clarkmt2/ECE_445_WaterBlaster/README.md

# ECE_445_WaterBlaster
Design, Firmware, and Documentation for Fully Electric Water Blaster
