clarkmt2/ECE_445_WaterBlaster/notebook/clarkmt2/SketchOfPreliminaryDesign.jpg

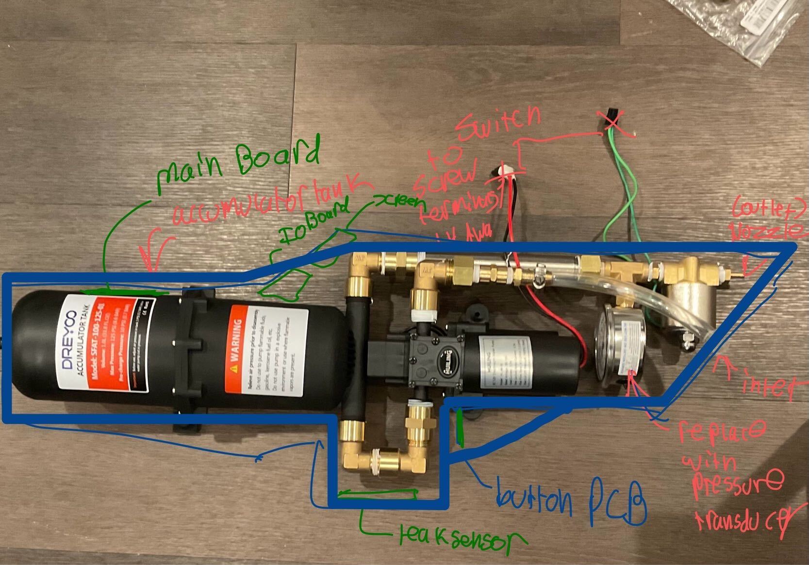
notebook/clarkmt2/SketchOfPreliminaryDesign.jpg
