clarkmt2/ECE_445_WaterBlaster/notebook/jaejin2/mechanicaldesign.png

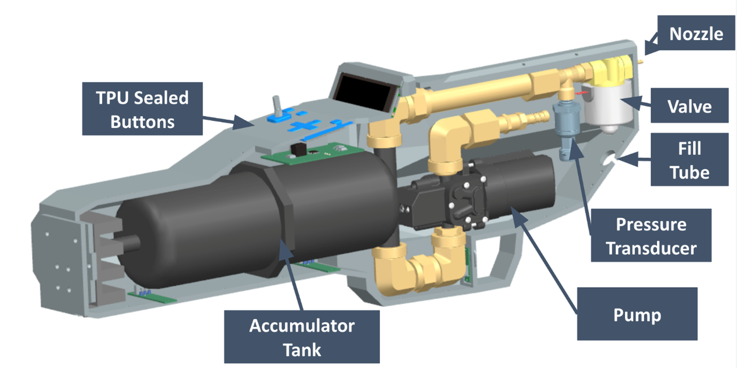
notebook/jaejin2/mechanicaldesign.png
