clarkmt2/ECE_445_WaterBlaster/cad_files/IOBoardV1.step

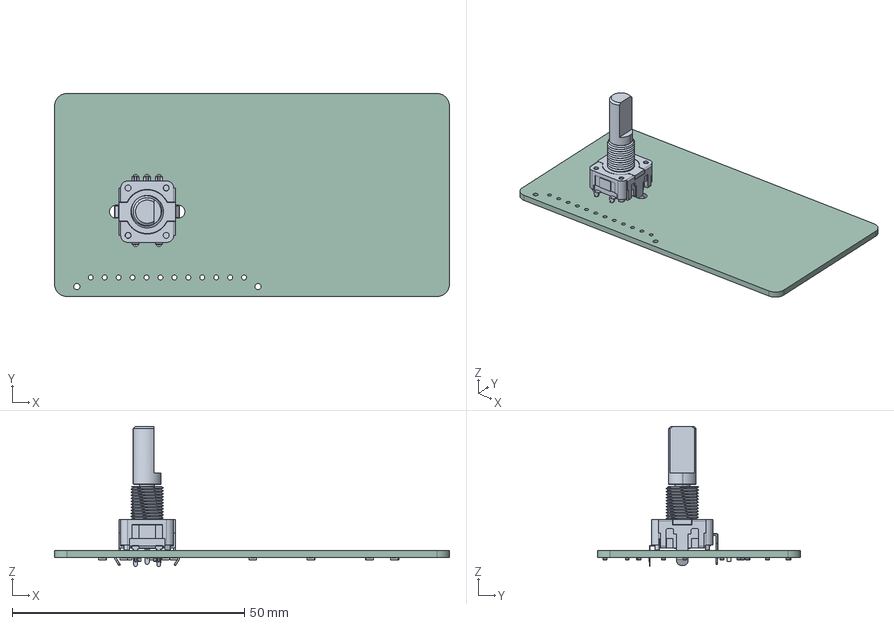
[picture p19: CAD file, 2025-04-20]
cad_files/IOBoardV1.step
85.0 x 43.7 x 30.2 mm
pec11r-4020f-s0024
C_0603_1608Metric x 2
R_0603_1608Metric x 20
IOBoardV1_PCB
