clarkmt2/ECE_445_WaterBlaster/cad_files/WaterBlasterV1.0/2WG025.STEP

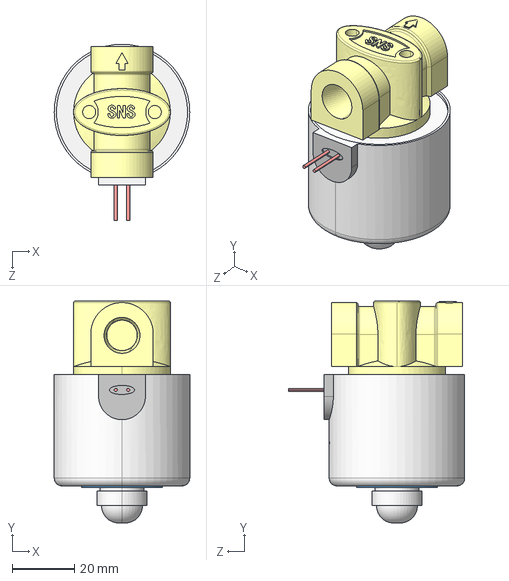
[picture p20: CAD file, 2025-04-20]
cad_files/WaterBlasterV1.0/2WG025.STEP
43.4 x 71.1 x 56.5 mm
