clarkmt2/ECE_445_WaterBlaster/pcb/IOBoardV1/IOBoardV1/TriggerButton V1/TriggerButton V1.step

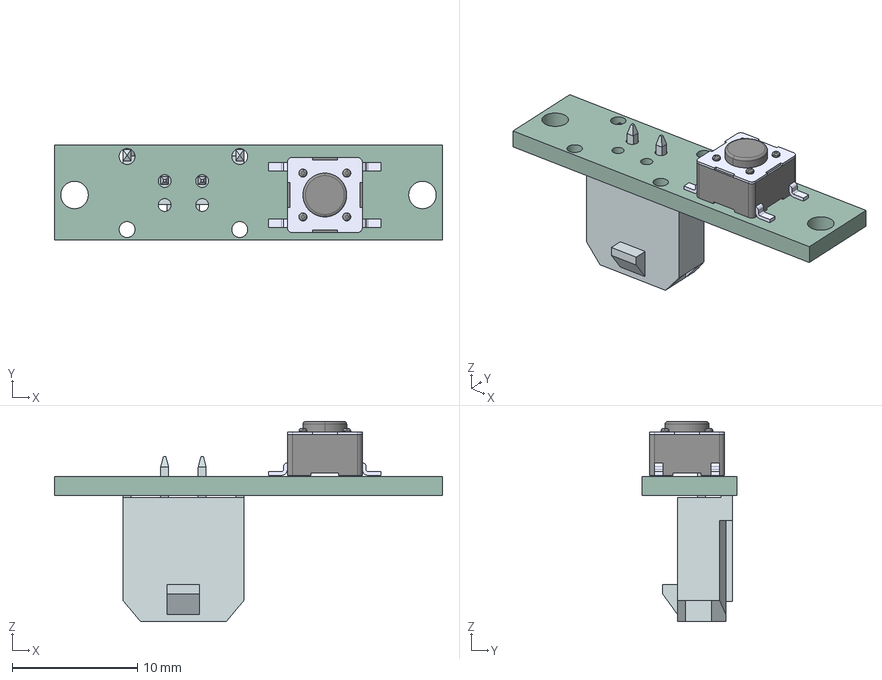
[picture p21: CAD file, 2025-05-02]
pcb/IOBoardV1/IOBoardV1/TriggerButton V1/TriggerButton V1.step
31.0 x 7.60 x 16.0 mm
PTS645SL43SMTR92 LFS
TriggerButton V1_PCB
