clarkmt2/ECE_445_WaterBlaster/pcb/LeakDetectionSensor/LeakDetectionSensorV1.step

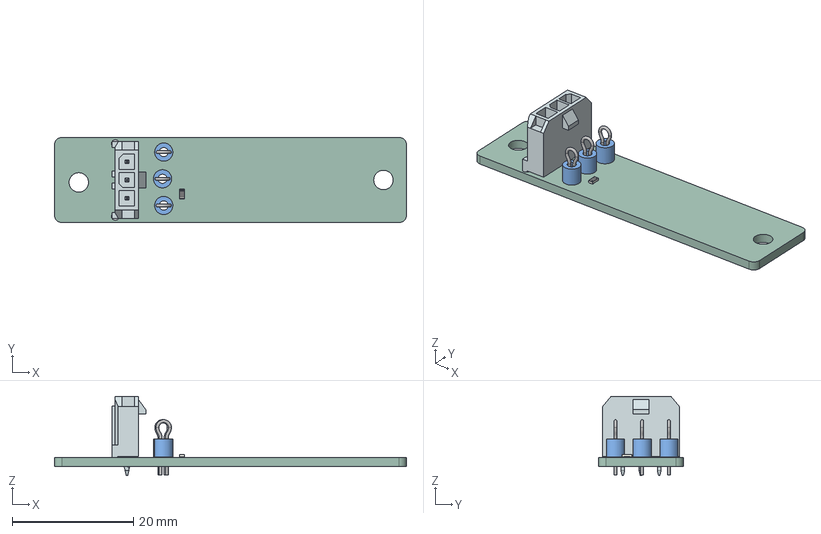
[picture p22: CAD file, 2025-04-20]
pcb/LeakDetectionSensor/LeakDetectionSensorV1.step
58.0 x 14.0 x 13.1 mm
TestPoint_Loop_D2.54mm_Drill1.5mm_Beaded x 3
R_0603_1608Metric
LeakDetectionSensorV1_PCB
