clarkmt2/ECE_445_WaterBlaster/pcb/WaterBlaster/WaterBlasterV2/WaterBlasterV2/WaterBlasterV2.step

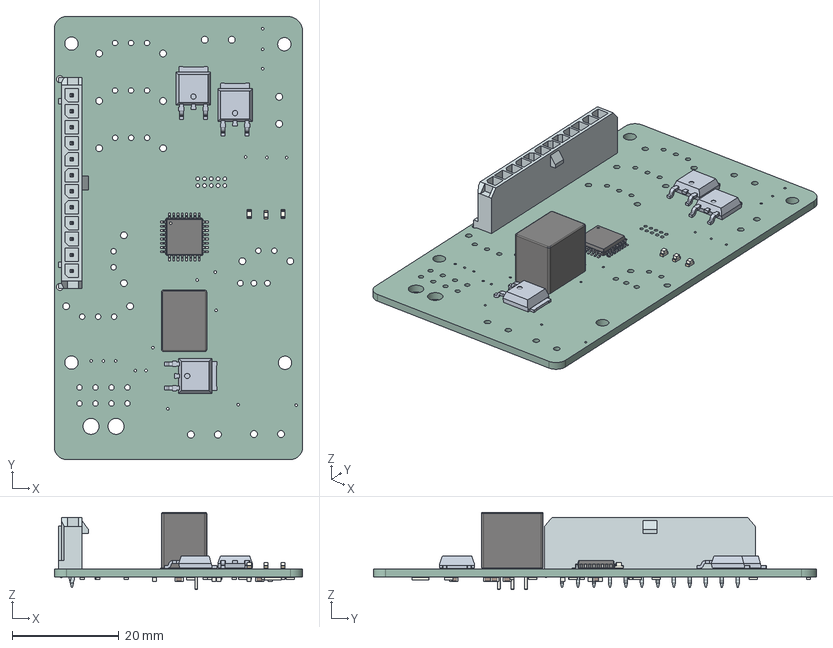
[picture p23: CAD file, 2025-04-20]
pcb/WaterBlaster/WaterBlasterV2/WaterBlasterV2/WaterBlasterV2.step
46.6 x 83.2 x 14.5 mm
LQFP-32_7x7mm_P0.8mm
WaterBlasterV2 1.2.1 x 3
LED_0603_1608Metric x 3
Converter_DCDC_RECOM_R-78E-0.5_THT
Fuse_1206_3216Metric x 2
R_0603_1608Metric x 12
C_0603_1608Metric x 8
Fuse_0603_1608Metric x 3
WaterBlasterV2_PCB
