clarkmt2/ECE_445_WaterBlaster/cad_files/WaterBlasterV1.0/0,250' NPT TEE.STEP

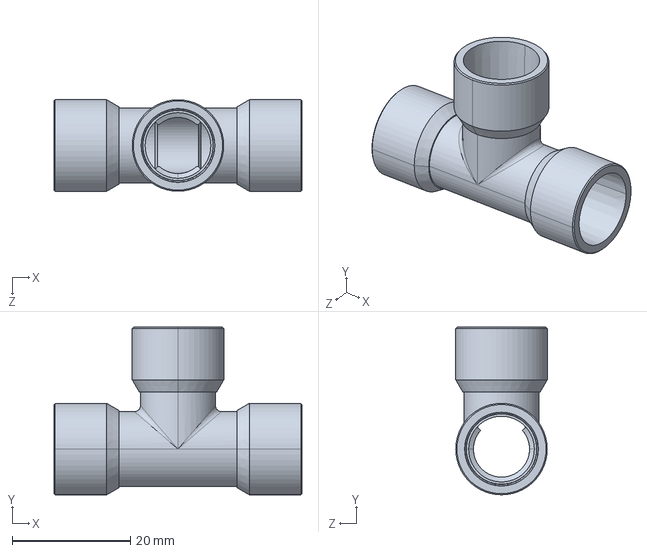
[picture p24: CAD file, 2025-04-20]
cad_files/WaterBlasterV1.0/0,250' NPT TEE.STEP
42.0 x 28.4 x 15.5 mm
