clarkmt2/ECE_445_WaterBlaster/cad_files/WaterBlasterV1.0/NHD-0420CW-AB3.step

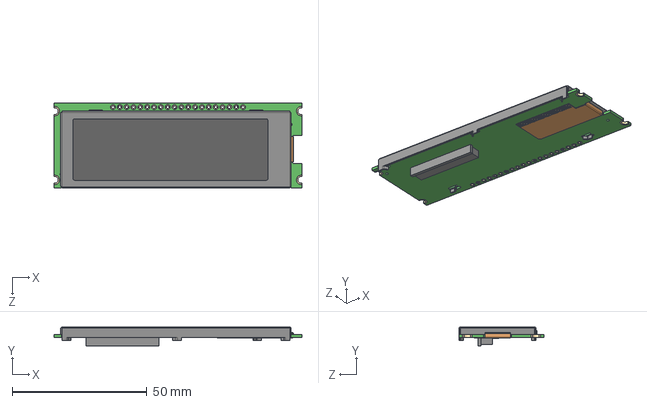
[picture p25: CAD file, 2025-03-13]
cad_files/WaterBlasterV1.0/NHD-0420CW-AB3.step
92.0 x 7.00 x 31.5 mm
