clarkmt2/ECE_445_WaterBlaster/(list of files, cad)

Other CAD files:
pcb/TriggerButton V1/TriggerButton V1.step
cad_files/0.25inNPTFemaleFemaleConnector.prt
cad_files/0.25inNPTFemaleFemaleConnectorv2.prt
cad_files/0.25inNPTMaleMaleConnector.prt
cad_files/0.25to0.125inNPTMaletoBarb.prt
cad_files/0.25to0.375inNPTMaletoBarb.prt
cad_files/0.25to0.5inNPTFemaletoMale.prt
cad_files/0.25to0.5inNPTMaletoFemaleAdapter.prt
cad_files/0.5inNPT90Degree.prt
cad_files/0.5inNPTFemaleFemaleCoupling.prt
cad_files/0.5inNPTMaleMaleConnector.prt
cad_files/436500227.prt
cad_files/436500315.prt
cad_files/436501215.prt
cad_files/C_0603_1608Metric.prt
cad_files/C_0603_1608Metric34313.prt
cad_files/Converter_DCDC_RECOM_R-78E-0.5_THT.prt
cad_files/Fuse_0603_1608Metric.prt
cad_files/Fuse_1206_3216Metric.prt
cad_files/IOBoardV1 _2__step.prt
cad_files/IOBoardV1_PCB.prt
cad_files/IOBoardV1_step.prt
cad_files/LED_0603_1608Metric.prt
cad_files/LQFP-32_7x7mm_P0.8mm.prt
cad_files/LeakDetectionSensorV1 _1__step.prt
cad_files/LeakDetectionSensorV1_PCB.prt
cad_files/NHD-0420CW-AB3.prt
cad_files/PTS645SL43SMTR92 LFS.prt
cad_files/PrusaBuildSizemk1.0.prt
cad_files/R_0603_1608Metric.prt
cad_files/R_0603_1608Metric33484.prt
cad_files/R_0603_1608Metric4886.prt
cad_files/TO-252-2.prt
cad_files/TestPoint_Loop_D2.54mm_Drill1.5mm_Beaded.prt
cad_files/TriggerButton V1 _1__step.prt
cad_files/TriggerButton V1_PCB.prt
cad_files/TriggerButton.prt
cad_files/WaterBlasterV1.0/0,250' NPT TEE.prt
cad_files/WaterBlasterV1.0/2WG025.prt
cad_files/WaterBlasterV1.0/BladderEnclosureV1.prt
cad_files/WaterBlasterV1.0/BladderEnclosureV2.prt
cad_files/WaterBlasterV1.0/NHD-0420CW-AB3.prt
cad_files/WaterBlasterV1.0/PrusaBuildSizemk1.0.prt
cad_files/WaterBlasterV1.0/Pump/90012-029-67.prt
cad_files/WaterBlasterV1.0/Pump/DIN7985-M4X16.prt
cad_files/WaterBlasterV1.0/Pump/DIN7991-M4X10.prt
cad_files/WaterBlasterV1.0/Pump/MDP-100-000_ASM.prt
cad_files/WaterBlasterV1.0/Pump/MDP-100-001.prt
cad_files/WaterBlasterV1.0/Pump/MDP-100-002.prt
cad_files/WaterBlasterV1.0/Pump/MDP-100-003.prt
cad_files/WaterBlasterV1.0/Pump/MDP-100-004.prt
cad_files/WaterBlasterV1.0/Pump/MDP-100-005.prt
cad_files/WaterBlasterV1.0/Pump/MDP-100-006.prt
cad_files/WaterBlasterV1.0/Pump/MDP-100-007.prt
cad_files/WaterBlasterV1.0/Pump/MDP-100-008.prt
cad_files/WaterBlasterV1.0/Pump/MDP-100-009.prt
cad_files/WaterBlasterV1.0/Pump/MDP-100-010.prt
cad_files/WaterBlasterV1.0/Pump/MDP-100-011.prt
cad_files/WaterBlasterV1.0/Pump/MDP-100-012.prt
cad_files/WaterBlasterV1.0/Pump/MDP-100-013.prt
cad_files/WaterBlasterV1.0/Pump/MDP-100-014.prt
cad_files/WaterBlasterV1.0/Pump/MDP-100-015.prt
cad_files/WaterBlasterV1.0/Pump/MDP-100-016.prt
cad_files/WaterBlasterV1.0/Pump/MDP-100-017.prt
cad_files/WaterBlasterV1.0/Pump/MDP-100-018.prt
cad_files/WaterBlasterV1.0/Pump/MDP-100-019.prt
cad_files/WaterBlasterV1.0/Pump/MDP-100-020.prt
cad_files/WaterBlasterV1.0/Pump/MDP-100-021.prt
cad_files/WaterBlasterV1.0/Pump/MDP-200-000_ASM.prt
cad_files/WaterBlasterV1.0/Pump/MDP-200-001.prt
cad_files/WaterBlasterV1.0/Pump/MDP-200-100_ASM.prt
cad_files/WaterBlasterV1.0/Pump/MDP-200-101.prt
cad_files/WaterBlasterV1.0/Pump/MDP-200-102.prt
cad_files/WaterBlasterV1.0/Pump/MDP-200-103.prt
cad_files/WaterBlasterV1.0/Pump/MDP-200-104.prt
cad_files/WaterBlasterV1.0/Pump/MDP-200-105.prt
cad_files/WaterBlasterV1.0/Pump/MDP-200-106.prt
cad_files/WaterBlasterV1.0/Pump/MDP-200-107.prt
cad_files/WaterBlasterV1.0/Pump/MDP-200-108.prt
cad_files/WaterBlasterV1.0/Pump/MDP-200-109.prt
cad_files/WaterBlasterV1.0/Pump/MDP-200-110.prt
cad_files/WaterBlasterV1.0/Pump/MDP-200-111.prt
cad_files/WaterBlasterV1.0/Pump/MDP-200-112.prt
cad_files/WaterBlasterV1.0/Pump/MDP-200-113.prt
cad_files/WaterBlasterV1.0/Pump/MDP-300-000.prt
cad_files/WaterBlasterV1.0/Pump/MDP-300-000_ASM.prt
cad_files/WaterBlasterV1.0/Pump/MDP-300-001.prt
cad_files/WaterBlasterV1.0/Pump/SKF_619_5-2Z_1_ASM.prt
cad_files/WaterBlasterV1.0/Pump/SKF_619_5-2Z_ASM.prt
cad_files/WaterBlasterV1.0/Pump/SKF_W_636-2RS1_1_ASM.prt
cad_files/WaterBlasterV1.0/Pump/SKF_W_636-2RS1_ASM.prt
cad_files/WaterBlasterV1.0/Pump/_SKF_619_5-2Z_PART1.prt
cad_files/WaterBlasterV1.0/Pump/_SKF_619_5-2Z_PART2.prt
cad_files/WaterBlasterV1.0/Pump/_SKF_619_5-2Z_PART3.prt
cad_files/WaterBlasterV1.0/Pump/_SKF_619_5-2Z_PART4.prt
cad_files/WaterBlasterV1.0/Pump/_SKF_W_636-2RS1_PART1.prt
cad_files/WaterBlasterV1.0/Pump/_SKF_W_636-2RS1_PART2.prt
cad_files/WaterBlasterV1.0/Pump/_SKF_W_636-2RS1_PART3.prt
cad_files/WaterBlasterV1.0/Pump/mdp-000-000.prt
cad_files/WaterBlasterV1.0/WaterBlasterLayoutV1.prt
cad_files/WaterBlasterV1.0/WaterBlasterV1.prt
cad_files/WaterBlasterV2 1.2.1.prt
cad_files/WaterBlasterV2 _2__step.prt
cad_files/WaterBlasterV2_PCB.prt
cad_files/accumulator.prt
cad_files/battery_holder.prt
cad_files/board1/43650121527303.prt
cad_files/board1/C_0603_1608Metric25576.prt
cad_files/board1/IOBoardV1_PCB167385.prt
cad_files/board1/IOBoardV1_copper.prt
cad_files/board1/IOBoardV1_silkscreen.prt
cad_files/board1/IOBoardV1_soldermask.prt
cad_files/board1/PTS645SL43SMTR92 LFS168.prt
cad_files/board1/R_0603_1608Metric26449.prt
cad_files/board1/pec11r-4020f-s00243929.prt
cad_files/button_covers.prt
cad_files/button_covers2.prt
cad_files/dcdc.prt
cad_files/pec11r-4020f-s0024.prt
cad_files/pressure_transducer.prt
cad_files/waterblaster_body_full.prt
cad_files/waterblaster_layout.prt
cad_files/waterblaster_leftback.prt
cad_files/waterblaster_leftfront.prt
cad_files/waterblaster_leftmiddle.prt
cad_files/waterblaster_leftnozzle.prt
cad_files/waterblaster_rightback.prt
cad_files/waterblaster_rightfront.prt
cad_files/waterblaster_rightmiddle.prt
cad_files/waterblaster_rightnozzle.prt
cad_files/waterblaster_section1.prt
cad_files/waterblaster_section2.prt
cad_files/waterblaster_wavelinkassembly.prt
