clarkmt2/ECE_445_WaterBlaster/pcb/WaterBlaster/WaterBlasterLite/WaterBlasterLite/WaterBlasterLite.kicad_pcb

## KiCad design pcb/WaterBlaster/WaterBlasterLite/WaterBlasterLite/WaterBlasterLite.kicad_pcb (2025-05-02)

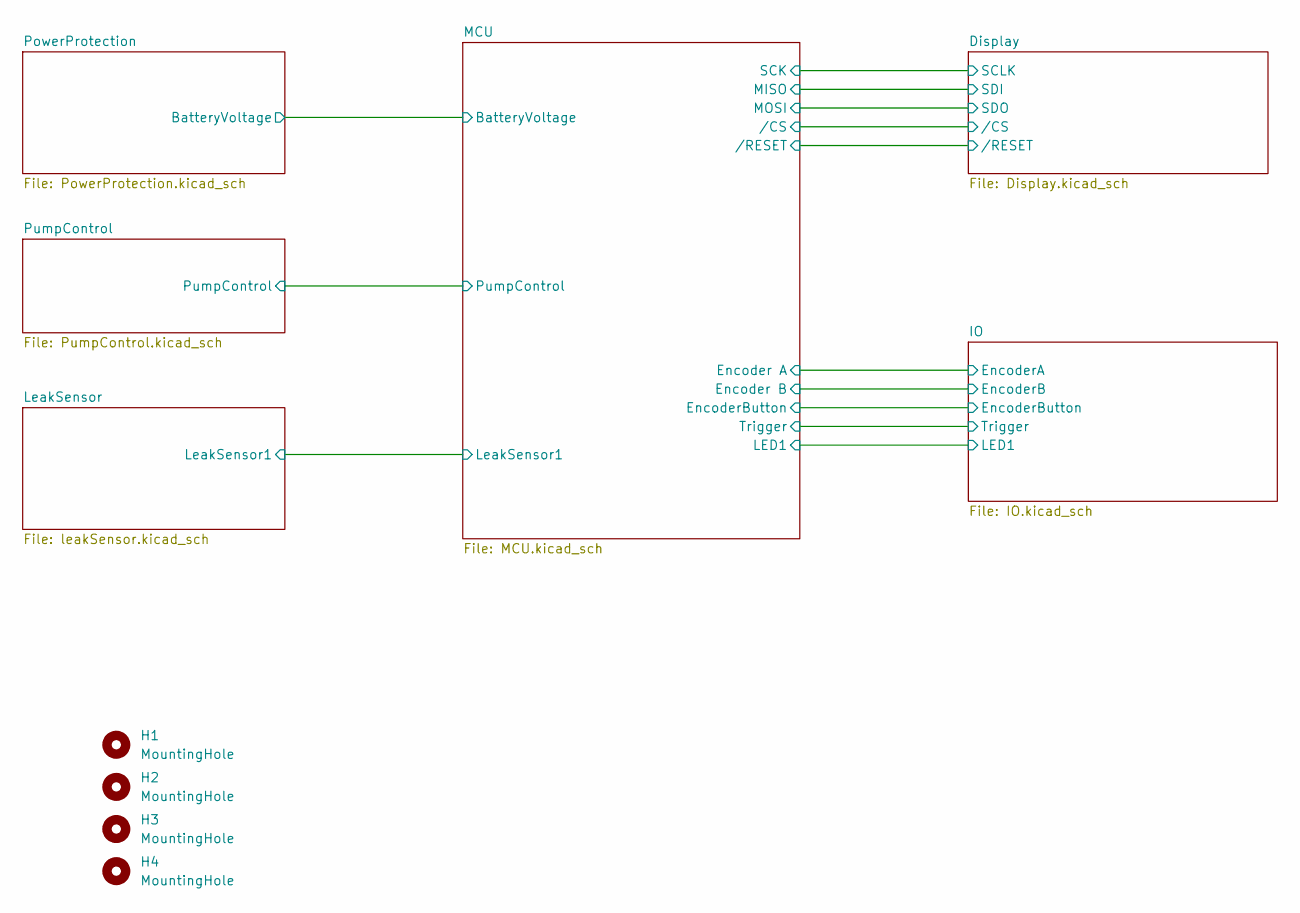
[picture p26: schematic WaterBlasterLite.kicad_sch]

Parts:
H1, H2, H3, H4: MountingHole; MountingHole_2.5mm

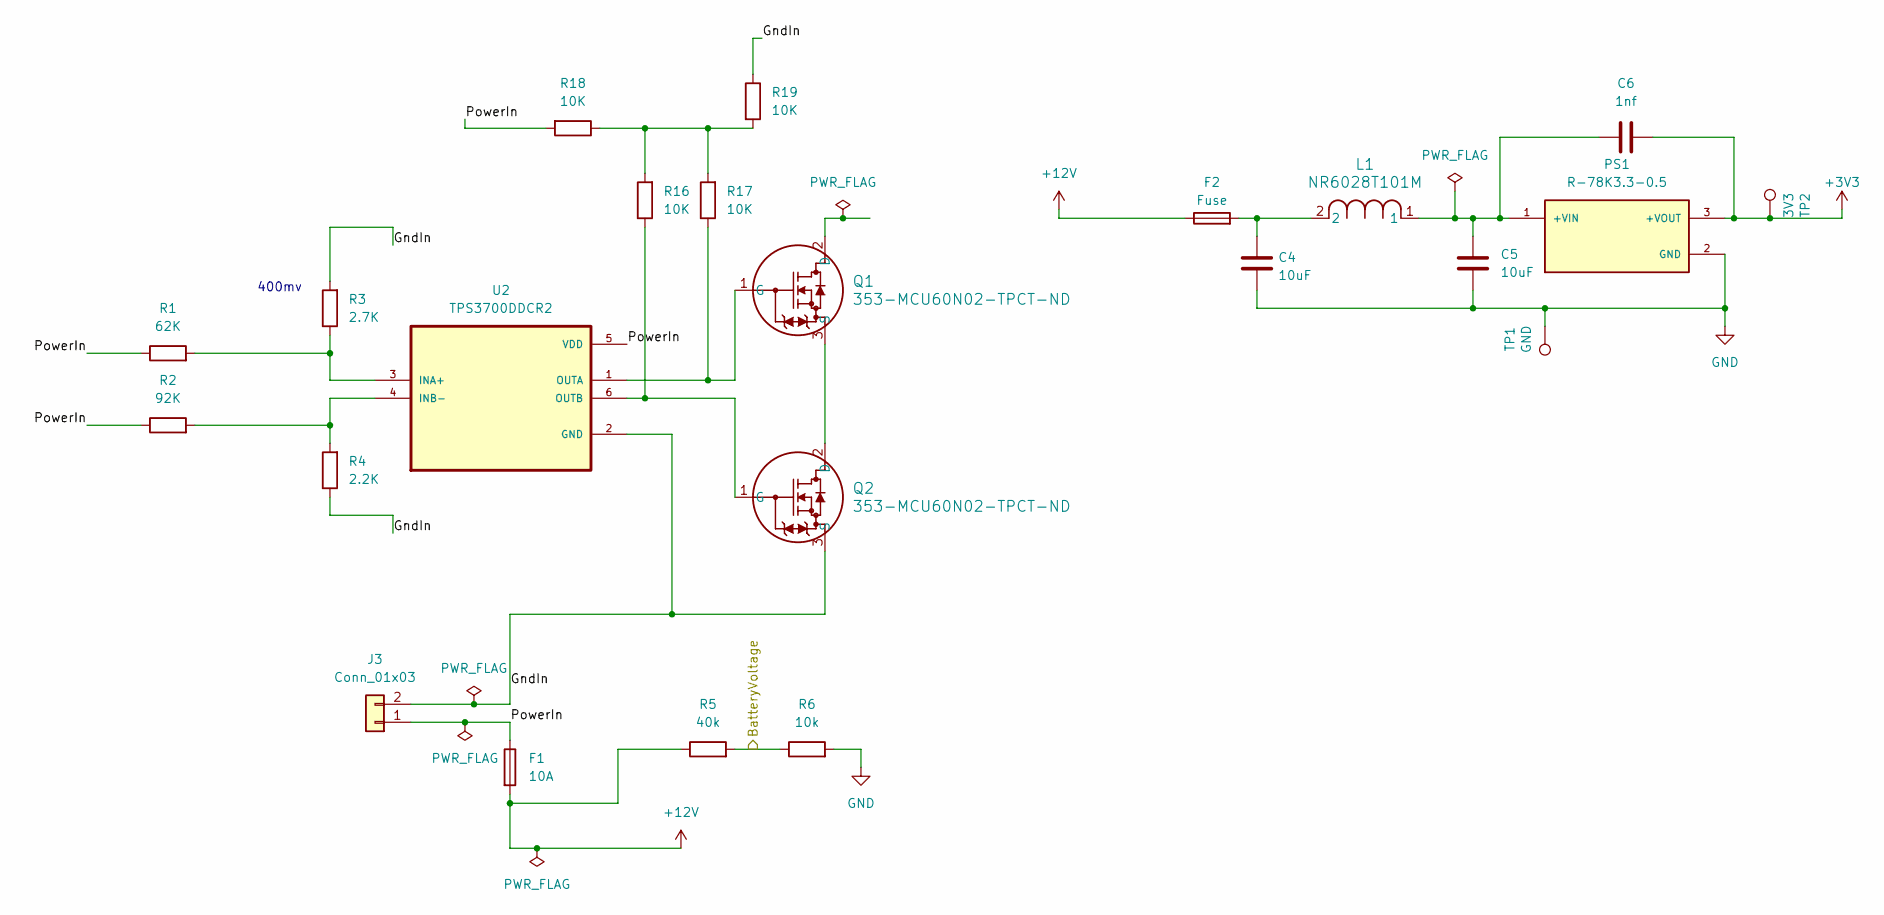
[picture p27: schematic PowerProtection.kicad_sch]

Parts:
C4: 10uF; C_0603_1608Metric_Pad1.08x0.95mm_HandSolder; MPN CAP CER 10UF 100V X5R 0603
C5: 10uF; C_0603_1608Metric_Pad1.08x0.95mm_HandSolder; MPN CAP CER 4.7UF 50V X5R 0603
C6: 1nf; C_0603_1608Metric_Pad1.08x0.95mm_HandSolder; MPN CAP CER 4.7UF 50V X5R 0603
F1: 10A; Fuse_1206_3216Metric
F2: Fuse; Fuse_0603_1608Metric
J3: Conn_01x03; PHOENIX_1985865
L1: NR6028T101M; IND_TAIYO_NR6028_TAY
PS1: R-78K3.3-0.5; CONV_R-78K3.3-0.5; PARTREV 0/2023
Q1, Q2: 353-MCU60N02-TPCT-ND; TO-252-2
R1: 62K; C_0603_1608Metric_Pad1.08x0.95mm_HandSolder
R2: 92K; C_0603_1608Metric_Pad1.08x0.95mm_HandSolder
R3: 2.7K; C_0603_1608Metric_Pad1.08x0.95mm_HandSolder
R4: 2.2K; C_0603_1608Metric_Pad1.08x0.95mm_HandSolder
R5: 40k; C_0603_1608Metric_Pad1.08x0.95mm_HandSolder
R6: 10k; C_0603_1608Metric_Pad1.08x0.95mm_HandSolder
R16, R17, R18, R19: 10K; C_0603_1608Metric_Pad1.08x0.95mm_HandSolder
TP1: GND; TestPoint_THTPad_D1.0mm_Drill0.5mm
TP2: 3V3; TestPoint_THTPad_D1.0mm_Drill0.5mm
U2: TPS3700DDCR2; SOT95P280X110-6N

Connections:
+3V3: C6.2, PS1.3 (+VOUT), TP2.1; also elsewhere on the board
+12V: F1.2, F2.1, R5.1; also elsewhere on the board
/MCU/BatteryVoltage: R5.2, R6.1; also elsewhere on the board
/PowerProtection/GndIn: J3.2, Q2.3 (S), R3.2, R4.1, R19.1, U2.2 (GND)
/PowerProtection/PowerIn: F1.1, J3.1, R1.1, R2.1, R18.2, U2.5 (VDD)
GND: C4.2, C5.2, PS1.2 (GND), R6.2, TP1.1; also elsewhere on the board
unnamed: C4.1, F2.2, L1.2
unnamed: C5.1, C6.1, L1.1, PS1.1 (+VIN)
unnamed: Q1.1 (G), R17.1, U2.1 (OUTA)
unnamed: Q1.3 (S), Q2.2 (D)
unnamed: Q2.1 (G), R16.1, U2.6 (OUTB)
unnamed: R16.2, R17.2, R18.1, R19.2
unnamed: R1.2, R3.1, U2.3 (INA+)
unnamed: R2.2, R4.2, U2.4 (INB-)

Notes on the sheet:
400mv

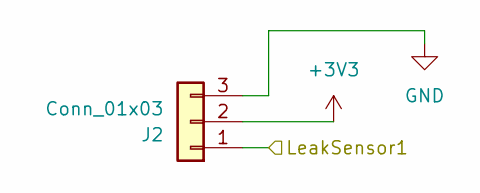
[picture p28: schematic leakSensor.kicad_sch]

Parts:
J2: Conn_01x03; MOLEX_436500317

Connections:
+3V3: J2.2; also elsewhere on the board
/LeakSensor/LeakSensor1: J2.1; also elsewhere on the board
GND: J2.3; also elsewhere on the board

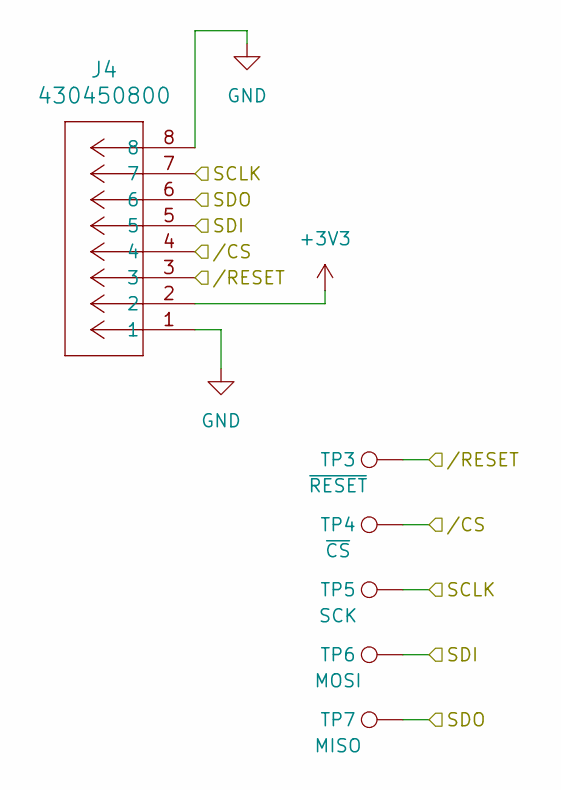
[picture p29: schematic Display.kicad_sch]

Parts:
J4: 430450800; CON_430450800_MOL
TP3: ~{RESET}; TestPoint_THTPad_D1.0mm_Drill0.5mm
TP4: ~{CS}; TestPoint_THTPad_D1.0mm_Drill0.5mm
TP5: SCK; TestPoint_THTPad_D1.0mm_Drill0.5mm
TP6: MOSI; TestPoint_THTPad_D1.0mm_Drill0.5mm
TP7: MISO; TestPoint_THTPad_D1.0mm_Drill0.5mm

Connections:
+3V3: J4.2; also elsewhere on the board
/Display/SCLK: J4.7, TP5.1; also elsewhere on the board
/Display/SDI: J4.5, TP6.1; also elsewhere on the board
/Display/SDO: J4.6, TP7.1; also elsewhere on the board
/Display//CS: J4.4, TP4.1; also elsewhere on the board
/Display//RESET: J4.3, TP3.1; also elsewhere on the board
GND: J4.1, J4.8; also elsewhere on the board

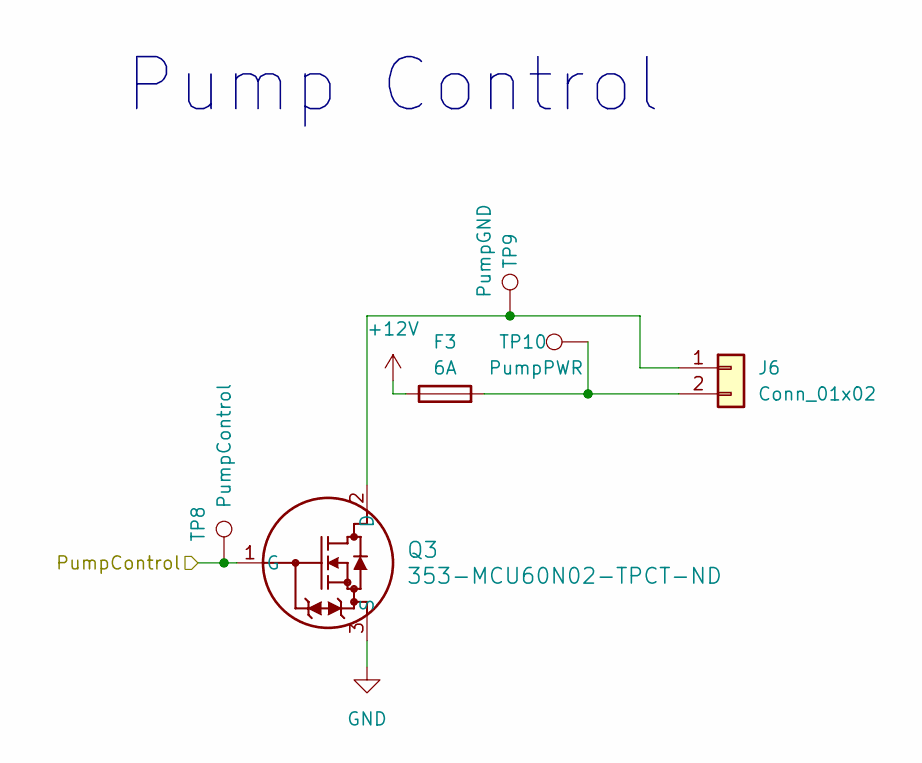
[picture p30: schematic PumpControl.kicad_sch]

Parts:
F3: 6A; Fuse_1206_3216Metric_Pad1.42x1.75mm_HandSolder
J6: Conn_01x02; PHOENIX_1985865
Q3: 353-MCU60N02-TPCT-ND; TO-252-2
TP8: PumpControl; TestPoint_THTPad_D1.0mm_Drill0.5mm
TP9: PumpGND; TestPoint_THTPad_D1.0mm_Drill0.5mm
TP10: PumpPWR; TestPoint_THTPad_D1.0mm_Drill0.5mm

Connections:
+12V: F3.1; also elsewhere on the board
/MCU/PumpControl: Q3.1 (G), TP8.1; also elsewhere on the board
GND: Q3.3 (S); also elsewhere on the board
unnamed: J6.1, Q3.2 (D), TP9.1
unnamed: F3.2, J6.2, TP10.1

Notes on the sheet:
Pump Control

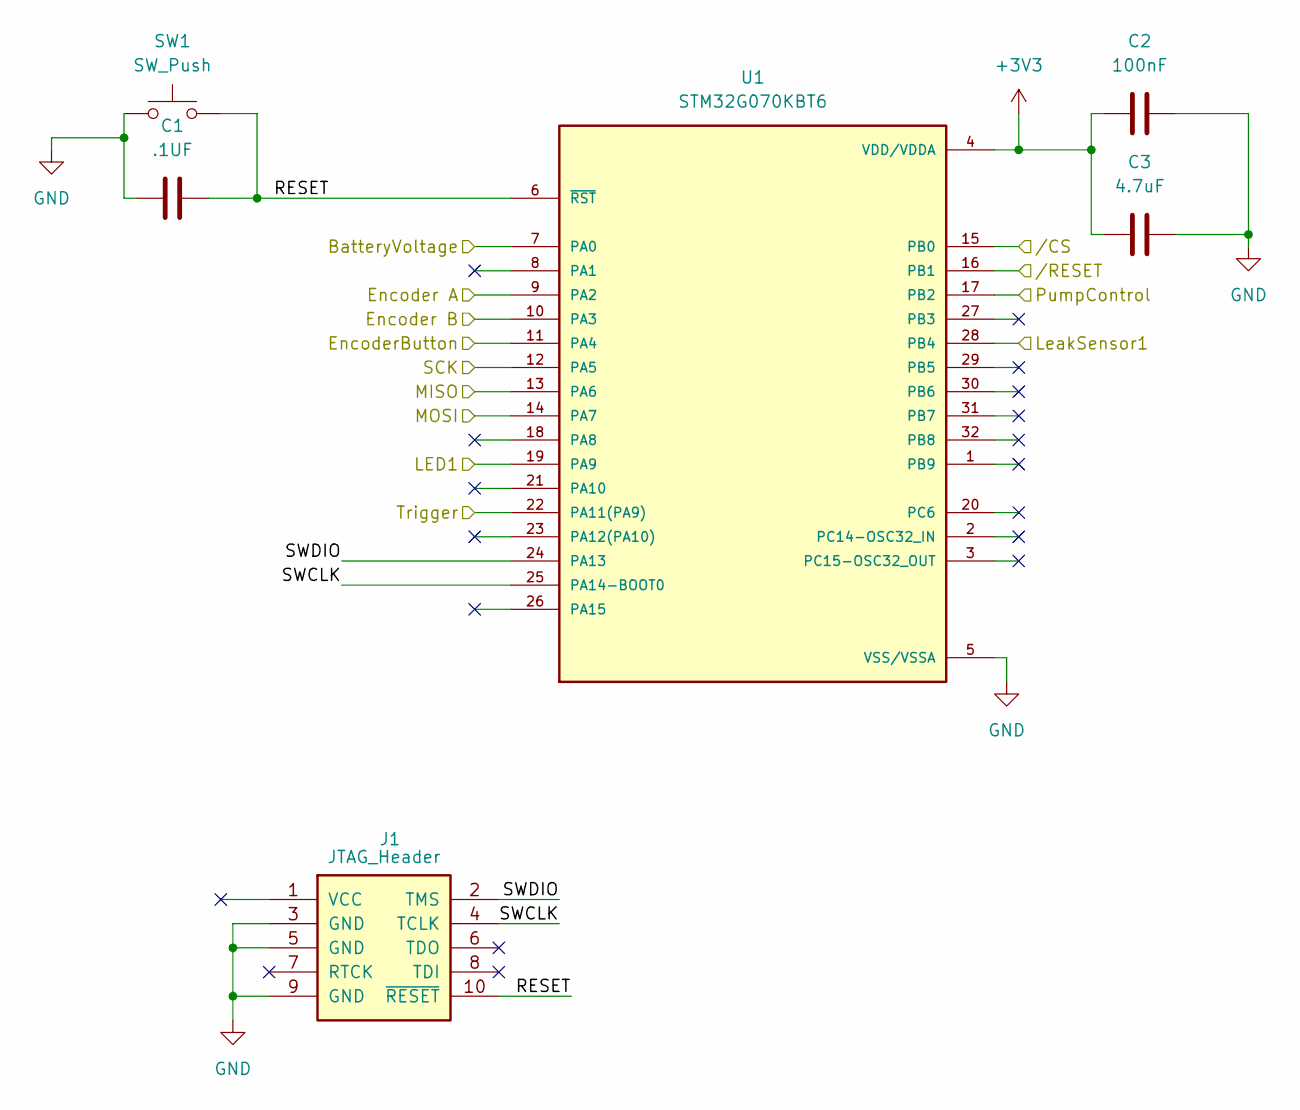
[picture p31: schematic MCU.kicad_sch]

Parts:
C1: .1UF; C_0603_1608Metric_Pad1.08x0.95mm_HandSolder
C2: 100nF; C_0603_1608Metric_Pad1.08x0.95mm_HandSolder
C3: 4.7uF; C_0603_1608Metric_Pad1.08x0.95mm_HandSolder
J1: JTAG_Header; CONN_3220-10-0100-00_CNC; MPN 3220-10-0100-00
SW1: SW_Push; PTS645SL43SMTR92LFS_CNK
U1: STM32G070KBT6; LQFP-32_7x7mm_P0.8mm; PARTREV 2

Connections:
+3V3: C2.1, C3.1, U1.4 (VDD/VDDA); also elsewhere on the board
/Display/SCLK: U1.12 (PA5); also elsewhere on the board
/Display/SDI: U1.13 (PA6); also elsewhere on the board
/Display/SDO: U1.14 (PA7); also elsewhere on the board
/Display//CS: U1.15 (PB0); also elsewhere on the board
/Display//RESET: U1.16 (PB1); also elsewhere on the board
/IO/EncoderA: U1.9 (PA2); also elsewhere on the board
/IO/EncoderB: U1.10 (PA3); also elsewhere on the board
/IO/EncoderButton: U1.11 (PA4); also elsewhere on the board
/IO/LED1: U1.19 (PA9); also elsewhere on the board
/IO/Trigger: U1.22 (PA11(PA9)); also elsewhere on the board
/LeakSensor/LeakSensor1: U1.28 (PB4); also elsewhere on the board
/MCU/BatteryVoltage: U1.7 (PA0); also elsewhere on the board
/MCU/PumpControl: U1.17 (PB2); also elsewhere on the board
/MCU/RESET: C1.1, J1.10 (~RESET), SW1.2, U1.6 (~RST)
/MCU/SWCLK: J1.4 (TCLK), U1.25 (PA14-BOOT0)
/MCU/SWDIO: J1.2 (TMS), U1.24 (PA13)
GND: C1.2, C2.2, C3.2, J1.3 (GND), J1.5 (GND), J1.9 (GND), SW1.1, U1.5 (VSS/VSSA); also elsewhere on the board

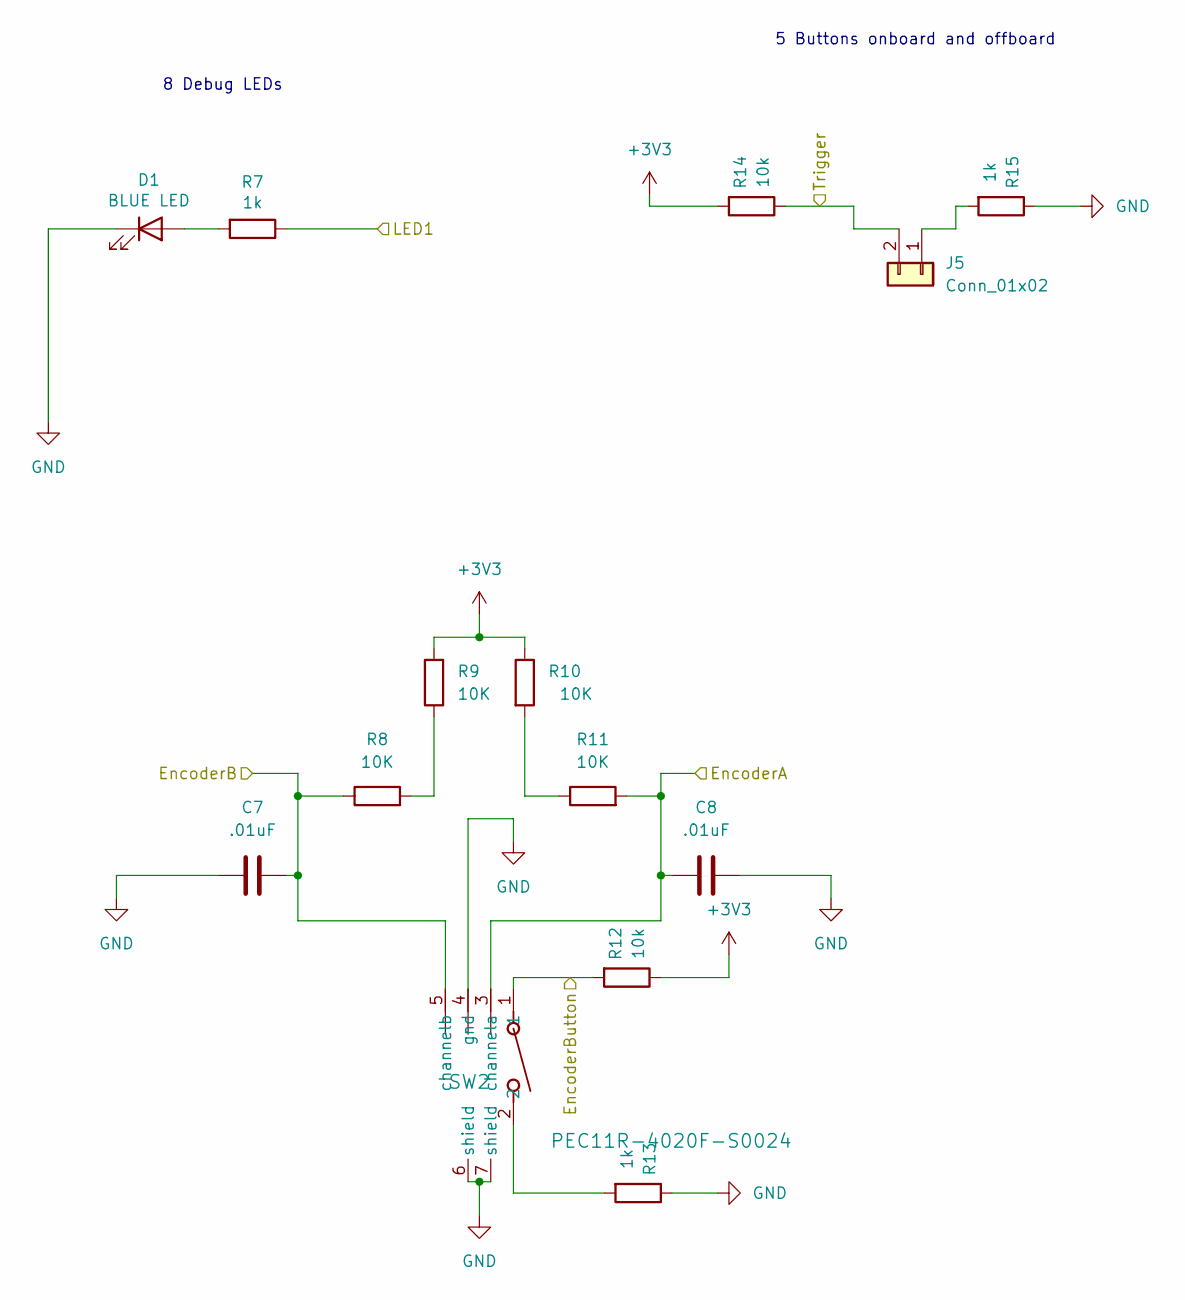
[picture p32: schematic IO.kicad_sch]

Parts:
C7, C8: .01uF; C_0603_1608Metric_Pad1.08x0.95mm_HandSolder
D1: BLUE LED; LED_0603_1608Metric_Pad1.05x0.95mm_HandSolder; MPN LED BLUE CLEAR 0603 SMD
J5: Conn_01x02; MOLEX_436500227
R7, R13, R15: 1k; R_0603_1608Metric_Pad0.98x0.95mm_HandSolder; MPN RES SMD 1K OHM 5% 1/10W 0603
R8, R9, R10, R11: 10K; R_0603_1608Metric_Pad0.98x0.95mm_HandSolder
R12, R14: 10k; R_0603_1608Metric_Pad0.98x0.95mm_HandSolder; MPN RES SMD 10K OHM 5% 1/10W 0603
SW2: PEC11R-4020F-S0024; SW_PEC11R-4XXXK-SXXXX_BRN

Connections:
+3V3: R9.2, R10.1, R12.1, R14.2; also elsewhere on the board
/IO/EncoderA: C8.1, R11.2, SW2.3 (channela); also elsewhere on the board
/IO/EncoderB: C7.2, R8.1, SW2.5 (channelb); also elsewhere on the board
/IO/EncoderButton: R12.2, SW2.1; also elsewhere on the board
/IO/LED1: R7.1; also elsewhere on the board
/IO/Trigger: J5.2, R14.1; also elsewhere on the board
GND: C7.1, C8.2, D1.1 (K), R13.1, R15.1, SW2.4 (gnd), SW2.6 (shield), SW2.7 (shield); also elsewhere on the board
unnamed: D1.2 (A), R7.2
unnamed: J5.1, R15.2
unnamed: R8.2, R9.1
unnamed: R10.2, R11.1
unnamed: R13.2, SW2.2

Notes on the sheet:
8 Debug LEDs
5 Buttons onboard and offboard

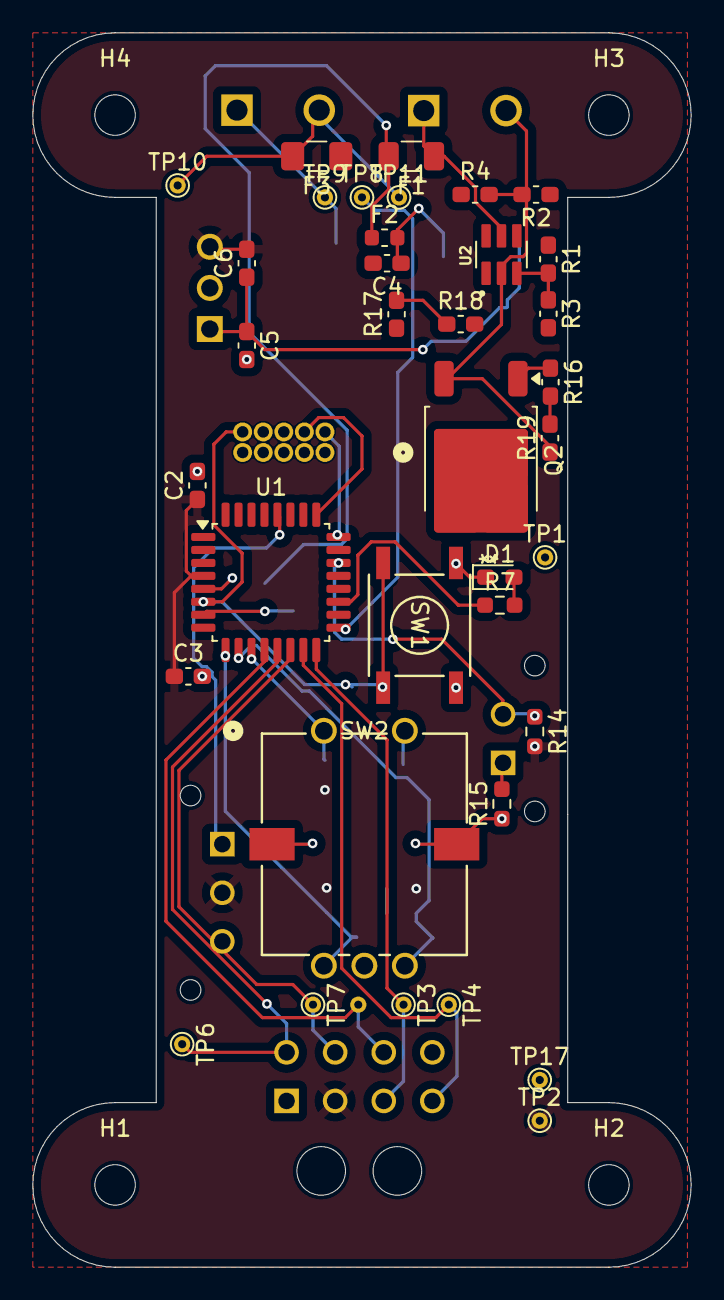
[picture p33: board WaterBlasterLite.kicad_pcb from above]

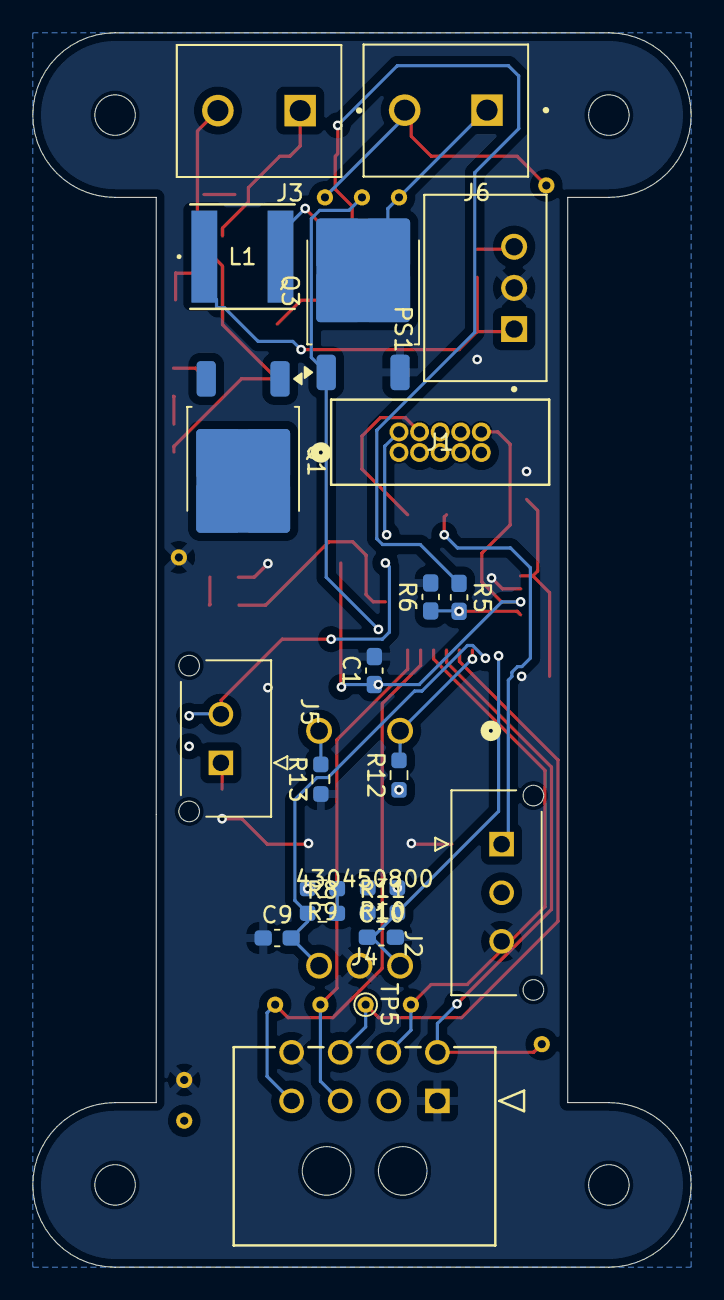
[picture p34: board WaterBlasterLite.kicad_pcb from below]

Board: 2 copper layers, 40.6 x 76.2 mm, 62 parts (22 on the bottom side), 36 nets.

Other parts of the board:
C9, C10: .01uF; C_0603_1608Metric_Pad1.08x0.95mm_HandSolder
TP11: PumpPWR; TestPoint_THTPad_D1.0mm_Drill0.5mm
TP17: GND; TestPoint_THTPad_D1.0mm_Drill0.5mm

Their connections:
/IO/EncoderA: C10.1; also elsewhere on the board
/IO/EncoderB: C9.2; also elsewhere on the board
GND: C9.1, C10.2, TP17.1; also elsewhere on the board
