clarkmt2/ECE_445_WaterBlaster/pcb/IOBoardV1/IOBoardV1/TriggerButton V1/TriggerButton V1.kicad_pcb

## KiCad design pcb/IOBoardV1/IOBoardV1/TriggerButton V1/TriggerButton V1.kicad_pcb (2025-05-02)

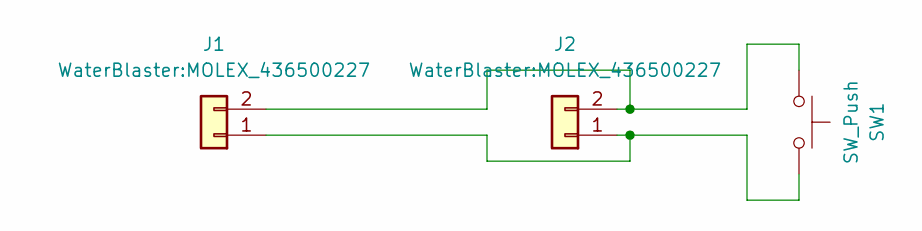
[picture p35: schematic TriggerButton V1.kicad_sch]

Parts:
J1, J2: WaterBlaster:MOLEX_436500227; MOLEX_436500227
SW1: SW_Push; PTS645SL43SMTR92LFS_CNK

Connections:
unnamed: J1.1, J2.1, SW1.2
unnamed: J1.2, J2.2, SW1.1

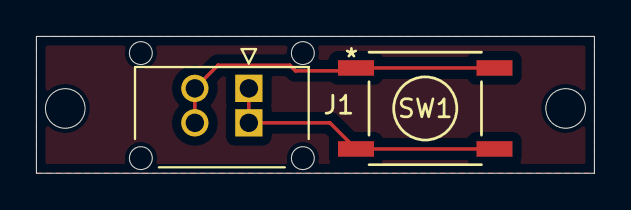
[picture p36: board TriggerButton V1.kicad_pcb from above]

Board: 2 copper layers, 31.0 x 7.6 mm, 5 parts (1 on the bottom side), 2 nets.

Other parts of the board:
H1, H2: MountingHole; MountingHole_2.2mm_M2
