clarkmt2/ECE_445_WaterBlaster/pcb/IOBoardV1/IOBoardV1/IOBoardV1.kicad_pcb

## KiCad design pcb/IOBoardV1/IOBoardV1/IOBoardV1.kicad_pcb (2025-05-02)

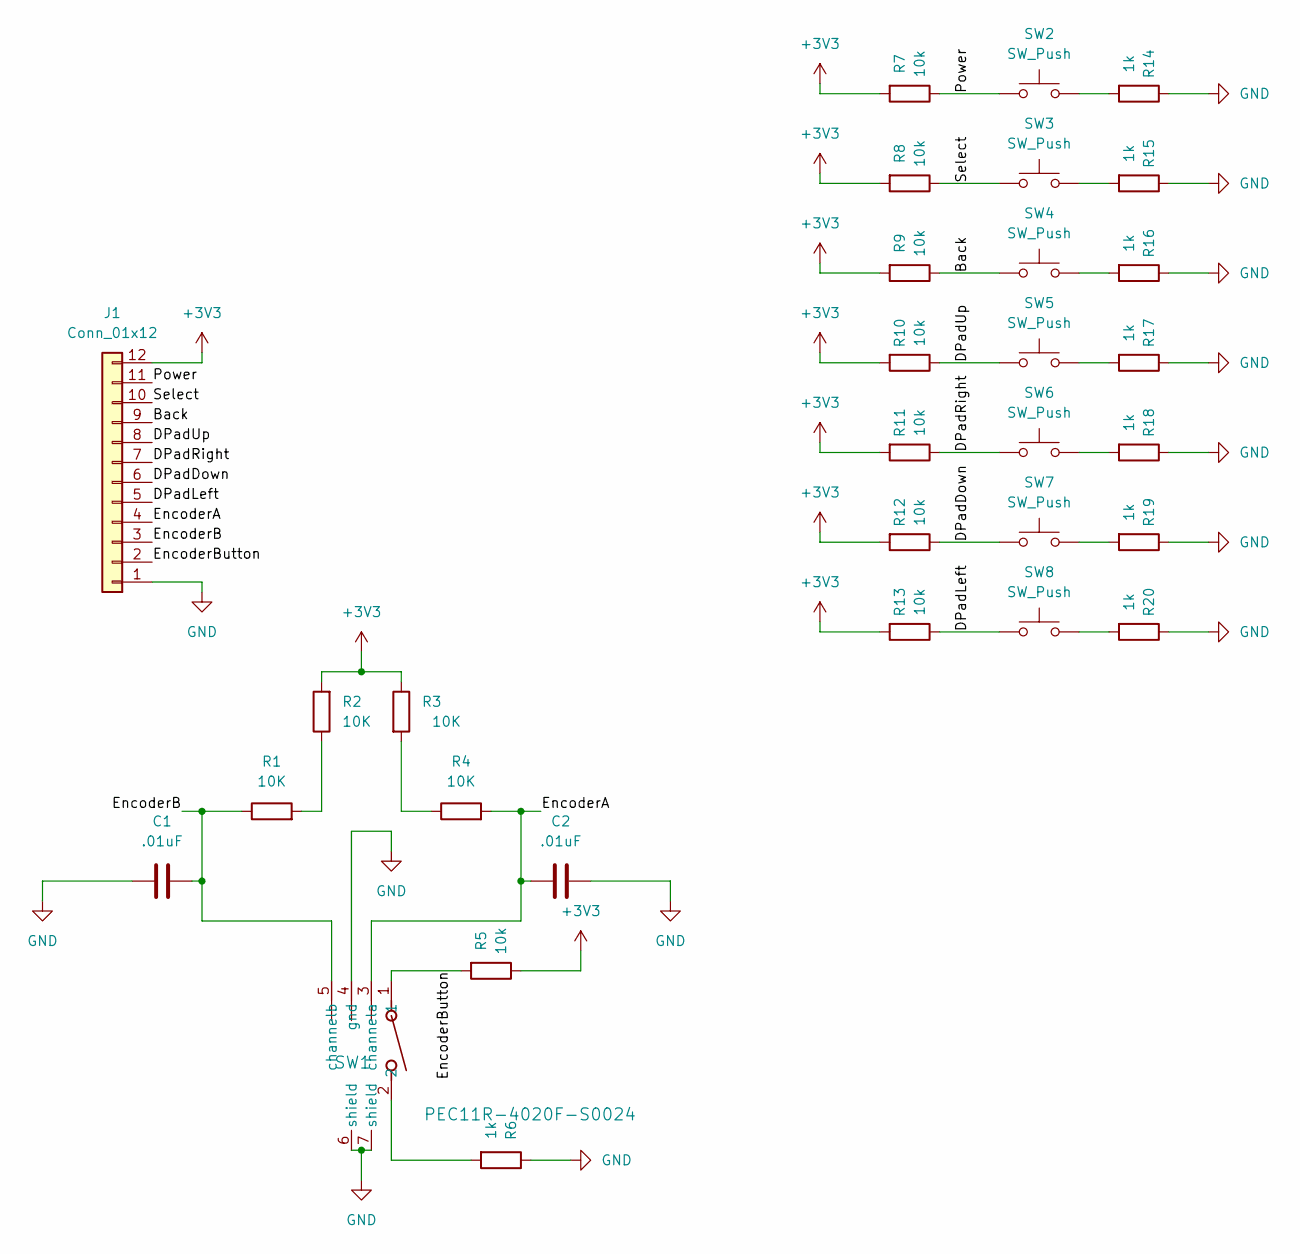
[picture p37: schematic IOBoardV1.kicad_sch]

Parts:
C1, C2: .01uF; C_0603_1608Metric_Pad1.08x0.95mm_HandSolder
J1: Conn_01x12; CONN_SD-43650-010_12_MOL
R1, R2, R3, R4: 10K; R_0603_1608Metric_Pad0.98x0.95mm_HandSolder
R5, R7, R8, R9, R10, R11, R12, R13: 10k; R_0603_1608Metric_Pad0.98x0.95mm_HandSolder; MPN RES SMD 10K OHM 5% 1/10W 0603
R6, R14, R15, R16, R17, R18, R19, R20: 1k; R_0603_1608Metric_Pad0.98x0.95mm_HandSolder; MPN RES SMD 1K OHM 5% 1/10W 0603
SW1: PEC11R-4020F-S0024; SW_PEC11R-4XXXK-SXXXX_BRN
SW2, SW3, SW4, SW5, SW6, SW7, SW8: SW_Push; PTS645SL43SMTR92LFS_CNK

Connections:
+3V3: J1.12, R2.2, R3.1, R5.1, R7.2, R8.2, R9.2, R10.2, R11.2, R12.2, R13.2
/Back: J1.9, R9.1, SW4.1
/DPadDown: J1.6, R12.1, SW7.1
/DPadLeft: J1.5, R13.1, SW8.1
/DPadRight: J1.7, R11.1, SW6.1
/DPadUp: J1.8, R10.1, SW5.1
/EncoderA: C2.1, J1.4, R4.2, SW1.3 (channela)
/EncoderB: C1.2, J1.3, R1.1, SW1.5 (channelb)
/EncoderButton: J1.2, R5.2, SW1.1
/Power: J1.11, R7.1, SW2.1
/Select: J1.10, R8.1, SW3.1
GND: C1.1, C2.2, J1.1, R6.1, R14.1, R15.1, R16.1, R17.1, R18.1, R19.1, R20.1, SW1.4 (gnd), SW1.6 (shield), SW1.7 (shield)
unnamed: R1.2, R2.1
unnamed: R3.2, R4.1
unnamed: R6.2, SW1.2
unnamed: R14.2, SW2.2
unnamed: R15.2, SW3.2
unnamed: R16.2, SW4.2
unnamed: R17.2, SW5.2
unnamed: R18.2, SW6.2
unnamed: R19.2, SW7.2
unnamed: R20.2, SW8.2

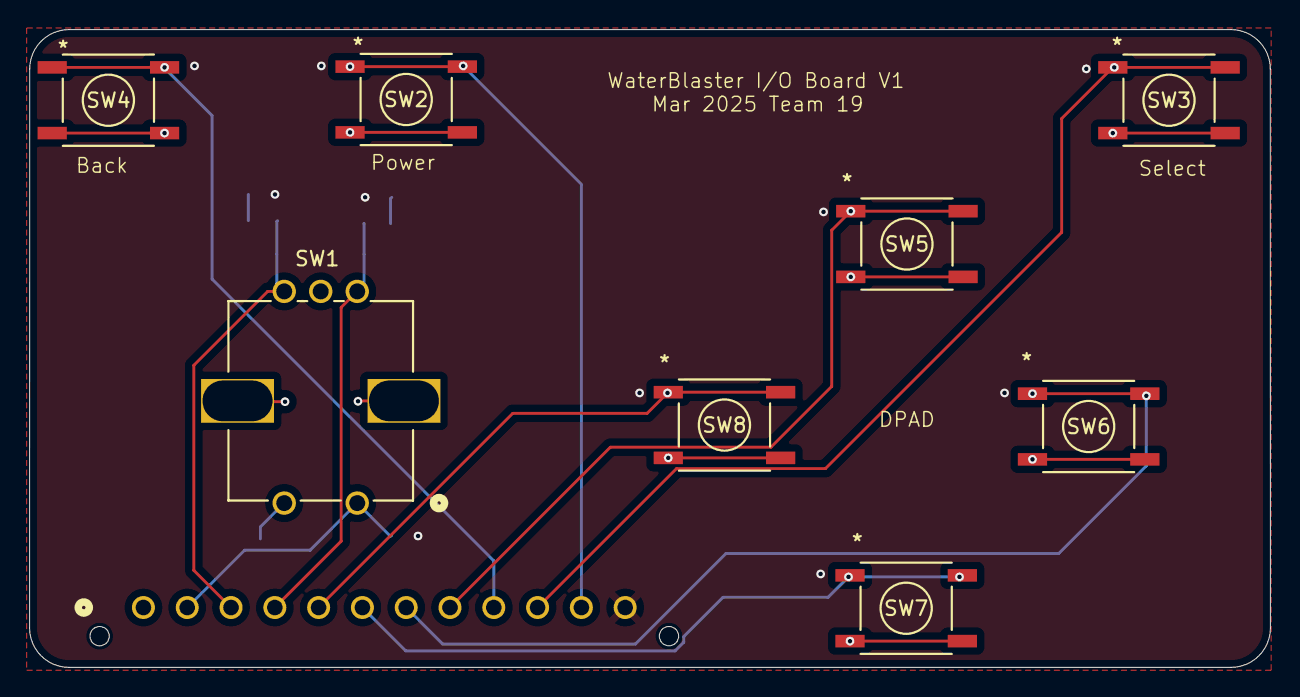
[picture p38: board IOBoardV1.kicad_pcb from above]

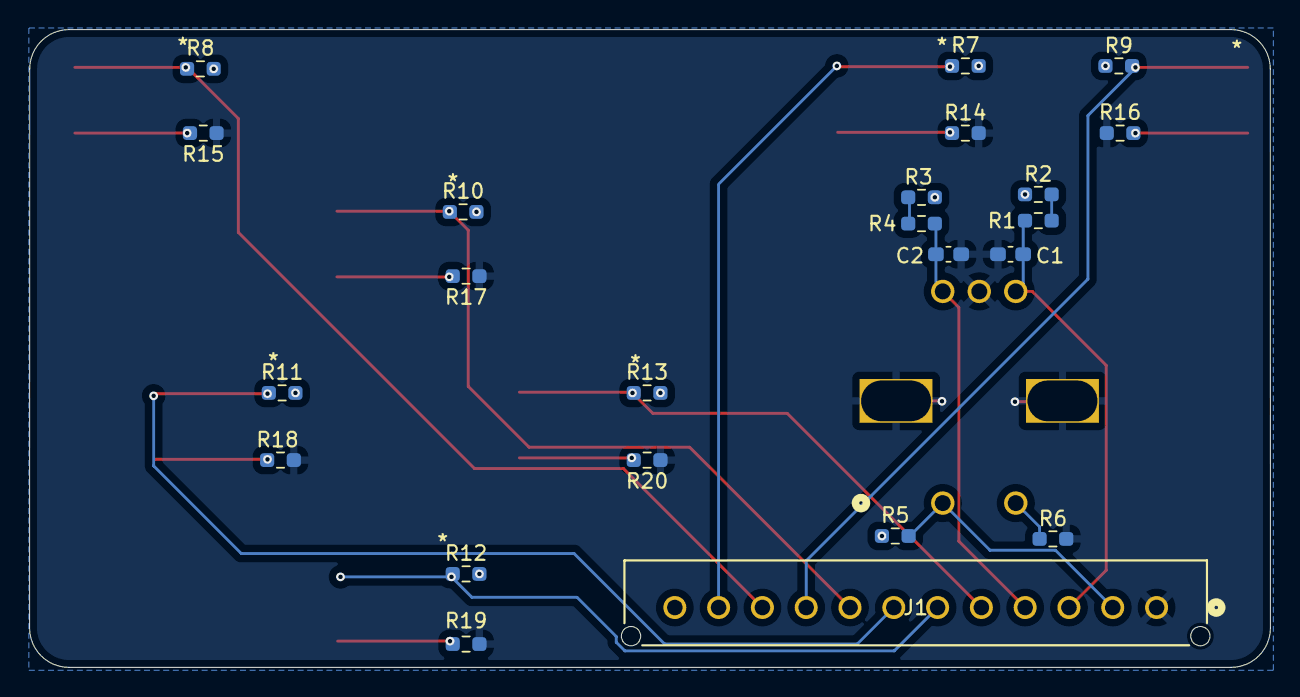
[picture p39: board IOBoardV1.kicad_pcb from below]

Board: 2 copper layers, 85.0 x 43.7 mm, 31 parts (23 on the bottom side), 22 nets.
