clarkmt2/ECE_445_WaterBlaster/pcb/LeakDetectionSensor/LeakDetectionSensorV1.kicad_pcb

## KiCad design pcb/LeakDetectionSensor/LeakDetectionSensorV1.kicad_pcb (2025-05-02)

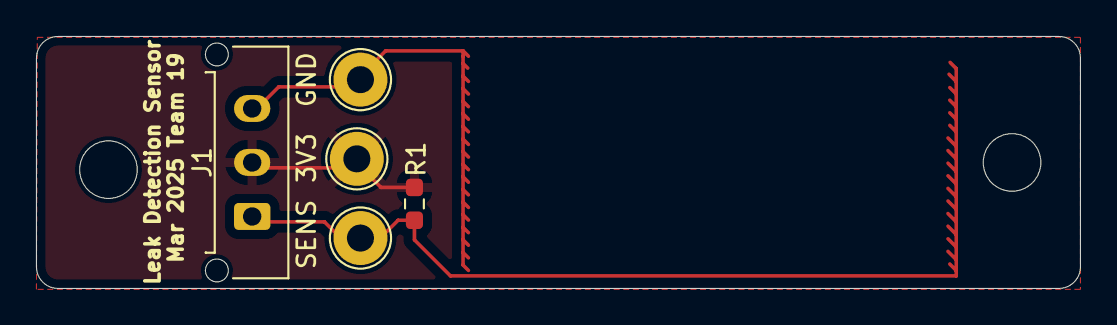
[picture p40: board LeakDetectionSensorV1.kicad_pcb from above]

Board: 2 copper layers, 58.0 x 14.0 mm, 7 parts (0 on the bottom side), 3 nets.

Parts:
3V3: 3V3; TestPoint_Loop_D2.54mm_Drill1.5mm_Beaded
GND: GND; TestPoint_Loop_D2.54mm_Drill1.5mm_Beaded
H1, H2: MountingHole; MountingHole_3.2mm_M3
J1: Conn_01x03; Molex_Micro-Fit_3.0_43650-0315_1x03_P3.00mm_Vertical
R1: 1M; R_0603_1608Metric_Pad0.98x0.95mm_HandSolder
SENS: SENS; TestPoint_Loop_D2.54mm_Drill1.5mm_Beaded

Connections:
+3V3: 3V3.1, J1.2, R1.1
GND: GND.1, J1.3
unnamed: J1.1, R1.2, SENS.1
