clarkmt2/ECE_445_WaterBlaster/pcb/WaterBlaster/WaterBlasterV2/WaterBlasterV2/WaterBlasterV2.kicad_pcb

## KiCad design pcb/WaterBlaster/WaterBlasterV2/WaterBlasterV2/WaterBlasterV2.kicad_pcb (2025-05-02)

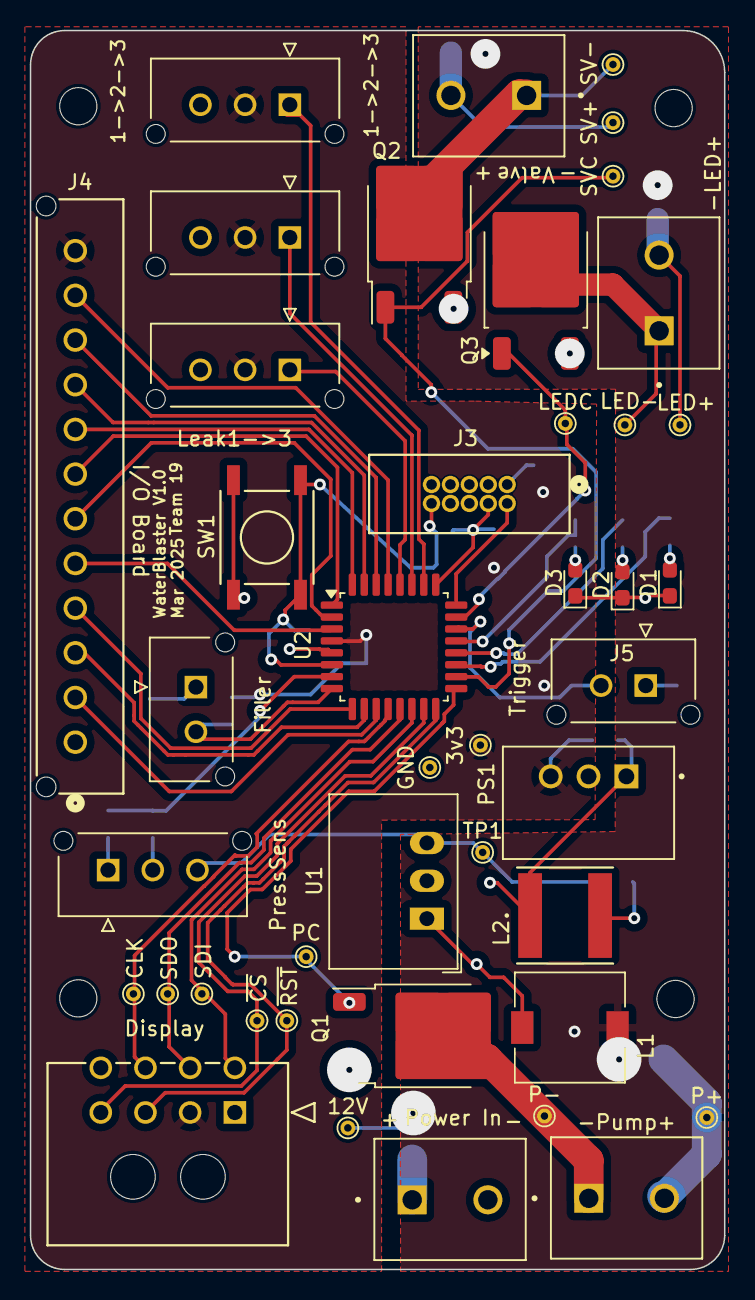
[picture p41: board WaterBlasterV2.kicad_pcb from above]

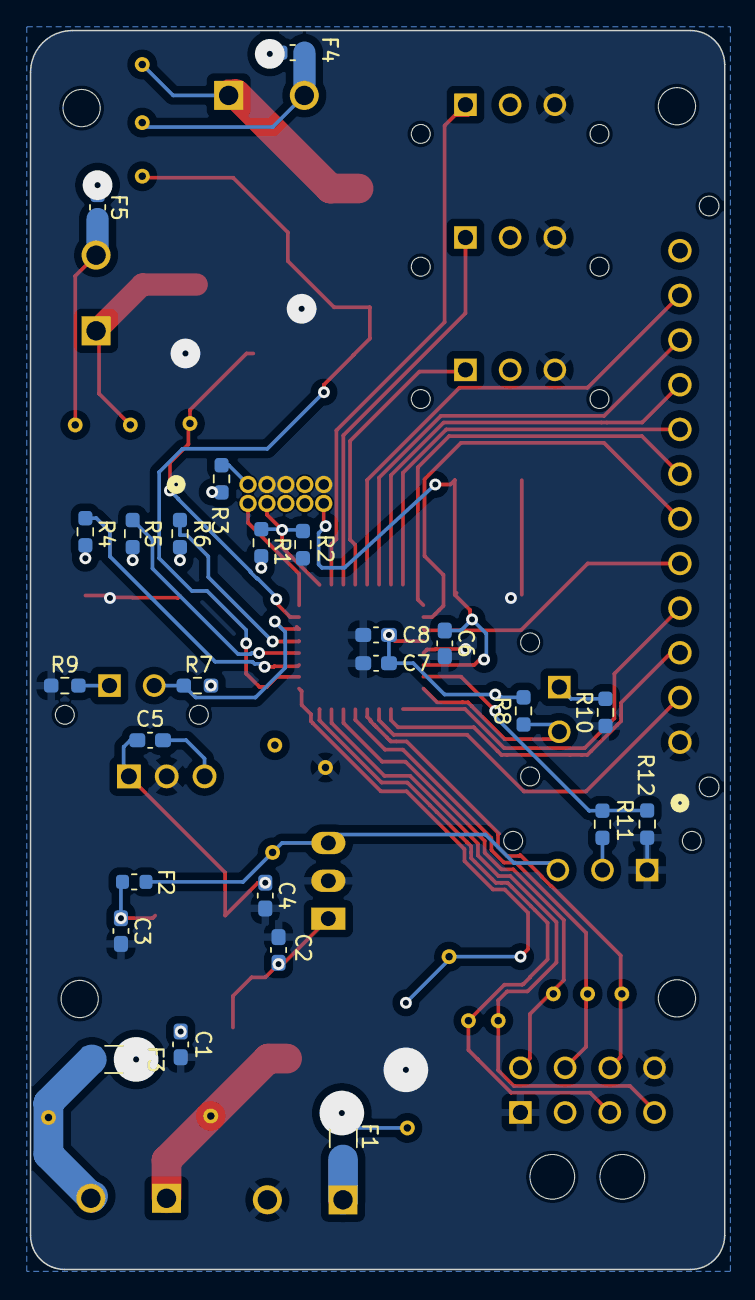
[picture p42: board WaterBlasterV2.kicad_pcb from below]

Board: 2 copper layers, 46.6 x 83.2 mm, 70 parts (28 on the bottom side), 51 nets.

Parts:
3v3: 3V3; TestPoint_THTPad_D1.0mm_Drill0.5mm
12V: 12V; TestPoint_THTPad_D1.0mm_Drill0.5mm
C1, C3, C4: 10uF; C_0603_1608Metric_Pad1.08x0.95mm_HandSolder
C2, C8: 4.7uF; C_0603_1608Metric_Pad1.08x0.95mm_HandSolder
C5: 1nf; C_0603_1608Metric_Pad1.08x0.95mm_HandSolder
C6: .1UF; C_0603_1608Metric_Pad1.08x0.95mm_HandSolder
C7: 100nF; C_0603_1608Metric_Pad1.08x0.95mm_HandSolder
CLK: SCK; TestPoint_THTPad_D1.0mm_Drill0.5mm
D1: BLUE LED; LED_0603_1608Metric_Pad1.05x0.95mm_HandSolder
D2: RED LED; LED_0603_1608Metric_Pad1.05x0.95mm_HandSolder
D3: YELLOW LED; LED_0603_1608Metric_Pad1.05x0.95mm_HandSolder
F1: 10A; Fuse_1206_3216Metric
F2: Fuse; Fuse_0603_1608Metric
F3: 6A; Fuse_1206_3216Metric_Pad1.42x1.75mm_HandSolder
F4, F5: 1.2A; Fuse_0603_1608Metric
Filler: Conn_01x02; MOLEX_436500227
GND: GND; TestPoint_THTPad_D1.0mm_Drill0.5mm
H1, H2, H3, H4: MountingHole; MountingHole_2.5mm
J1, J9, J14: Conn_01x03; PHOENIX_1985865
J2: 430450800; CON_430450800_MOL
J3: JTAG_Header; CONN_3220-10-0100-00_CNC
J4: Conn_01x12; CONN_SD-43650-010_12_MOL
J5: Conn_01x02; MOLEX_436500227
J7: Conn_01x02; PHOENIX_1985865
J10, J11, J13: Conn_01x03; MOLEX_436500317
L1: 12uH; L_7.3x7.3_H3.5
L2: NR6028T101M; IND_TAIYO_NR6028_TAY
LED+: LEDPWR; TestPoint_THTPad_D1.0mm_Drill0.5mm
LED-: LEDGND; TestPoint_THTPad_D1.0mm_Drill0.5mm
LEDC: LEDControl; TestPoint_THTPad_D1.0mm_Drill0.5mm
P+: PumpPWR; TestPoint_THTPad_D1.0mm_Drill0.5mm
P-: PumpGND; TestPoint_THTPad_D1.0mm_Drill0.5mm
PC: PumpControl; TestPoint_THTPad_D1.0mm_Drill0.5mm
PS1: R-78K3.3-0.5; CONV_R-78K3.3-0.5
PressSens: Conn_01x03; MOLEX_436500317
Q1, Q2, Q3: 353-MCU60N02-TPCT-ND; TO-252-2
R1, R2: R; R_0603_1608Metric_Pad0.98x0.95mm_HandSolder
R3: 0; R_0603_1608Metric_Pad0.98x0.95mm_HandSolder
R4, R5, R6, R9, R10: 1k; R_0603_1608Metric_Pad0.98x0.95mm_HandSolder
R7, R8: 10k; R_0603_1608Metric_Pad0.98x0.95mm_HandSolder
R11, R12: 10K; R_0603_1608Metric_Pad0.98x0.95mm_HandSolder
SDI: MOSI; TestPoint_THTPad_D1.0mm_Drill0.5mm
SDO: MISO; TestPoint_THTPad_D1.0mm_Drill0.5mm
SV+: ValvePWR; TestPoint_THTPad_D1.0mm_Drill0.5mm
SV-: ValveGND; TestPoint_THTPad_D1.0mm_Drill0.5mm
SVC: ValveControl; TestPoint_THTPad_D1.0mm_Drill0.5mm
SW1: SW_Push; PTS645SL43SMTR92LFS_CNK
TP1: 5v Protected; TestPoint_THTPad_D1.0mm_Drill0.5mm
U1: R-78E5.0-0.5; Converter_DCDC_RECOM_R-78E-0.5_THT
U2: STM32G070KBT6; LQFP-32_7x7mm_P0.8mm

Connections:
+3V3: 3v3.1, C5.2, C7.1, C8.1, J2.2, J4.12, J10.2, J11.2, J13.2, PS1.3 (+VOUT), R1.1, R3.1, R7.2, R8.2, U2.4 (VDD/VDDA)
+5V: F2.1, PressSens.3, TP1.1, U1.3 (OUT)
+12V: 12V.1, C1.1, F1.2, F3.1, F4.1, F5.1, L1.1
/Display/SCLK: CLK.1, J2.7, U2.12 (PA5)
/Display/SDI: J2.5, SDI.1, U2.14 (PA7)
/Display/SDO: J2.6, SDO.1, U2.13 (PA6)
/Display//CS: J2.4, U2.15 (PB0)
/Display//RESET: J2.3, U2.16 (PB1)
/IO/Back: J4.9, U2.31 (PB7)
/IO/DPadDown: J4.6, U2.2 (PC14-OSC32_IN)
/IO/DPadLeft: J4.5, U2.3 (PC15-OSC32_OUT)
/IO/DPadRight: J4.7, U2.1 (PB9)
/IO/DPadUp: J4.8, U2.32 (PB8)
/IO/EncoderA: J4.4, U2.9 (PA2)
/IO/EncoderB: J4.3, U2.10 (PA3)
/IO/EncoderButton: J4.2, U2.11 (PA4)
/IO/Filler: Filler.2, R8.1, U2.8 (PA1)
/IO/LED1: R4.1, U2.19 (PA9)
/IO/LED2: R5.1, U2.20 (PC6)
/IO/LED3: R6.1, U2.21 (PA10)
/IO/Power: J4.11, U2.29 (PB5)
/IO/Select: J4.10, U2.30 (PB6)
/IO/Trigger: J5.2, R7.1, U2.22 (PA11(PA9))
/MCU/LEDControl: LEDC.1, Q3.1 (G), U2.23 (PA12(PA10))
/MCU/LeakSensor1: J10.1, U2.28 (PB4)
/MCU/LeakSensor2: J11.1, U2.27 (PB3)
/MCU/LeakSensor3: J13.1, U2.26 (PA15)
/MCU/PressureTransducer: R11.1, R12.2, U2.7 (PA0)
/MCU/PumpControl: PC.1, Q1.1 (G), U2.17 (PB2)
/MCU/RESET: C6.1, J3.10 (~RESET), SW1.2, U2.6 (~RST)
/MCU/SWCLK: J3.4 (TCLK), R1.2, R2.2, U2.25 (PA14-BOOT0)
/MCU/SWDIO: J3.2 (TMS), U2.24 (PA13)
/MCU/ValveControl: Q2.1 (G), SVC.1, U2.18 (PA8)
GND: C1.2, C2.2, C3.2, C4.2, C6.2, C7.2, C8.2, D1.1 (K), D2.1 (K), D3.1 (K), GND.1, J1.2, J2.1, J2.8, J3.3 (GND), J3.5 (GND), J3.9 (GND), J4.1, J10.3, J11.3, J13.3, PS1.2 (GND), PressSens.1, Q1.3 (S), Q2.3 (S), Q3.3 (S), R2.1, R9.1, R10.1, R12.1, SW1.1, U1.2 (GND), U2.5 (VSS/VSSA)
unnamed: C3.1, F2.2, L2.2
unnamed: D1.2 (A), R4.2
unnamed: D2.2 (A), R5.2
unnamed: D3.2 (A), R6.2
unnamed: F1.1, J1.1
unnamed: J3.1 (VCC), R3.2
unnamed: J5.1, R9.2
unnamed: Filler.1, R10.2
unnamed: J7.1, P-.1, Q1.2 (D)
unnamed: F3.2, J7.2, P+.1
unnamed: J9.1, LED-.1, Q3.2 (D)
unnamed: F5.2, J9.2, LED+.1
unnamed: PressSens.2, R11.2
unnamed: J14.1, Q2.2 (D), SV-.1
unnamed: F4.2, J14.2, SV+.1
unnamed: C4.1, C5.1, L2.1, PS1.1 (+VIN)
unnamed: C2.1, L1.2, U1.1 (IN)
