clarkmt2/ECE_445_WaterBlaster/pcb/WaterBlaster/WaterBlasterV1/WaterBlaster.kicad_pcb

## KiCad design pcb/WaterBlaster/WaterBlasterV1/WaterBlaster.kicad_pcb (2025-03-04, an earlier design)

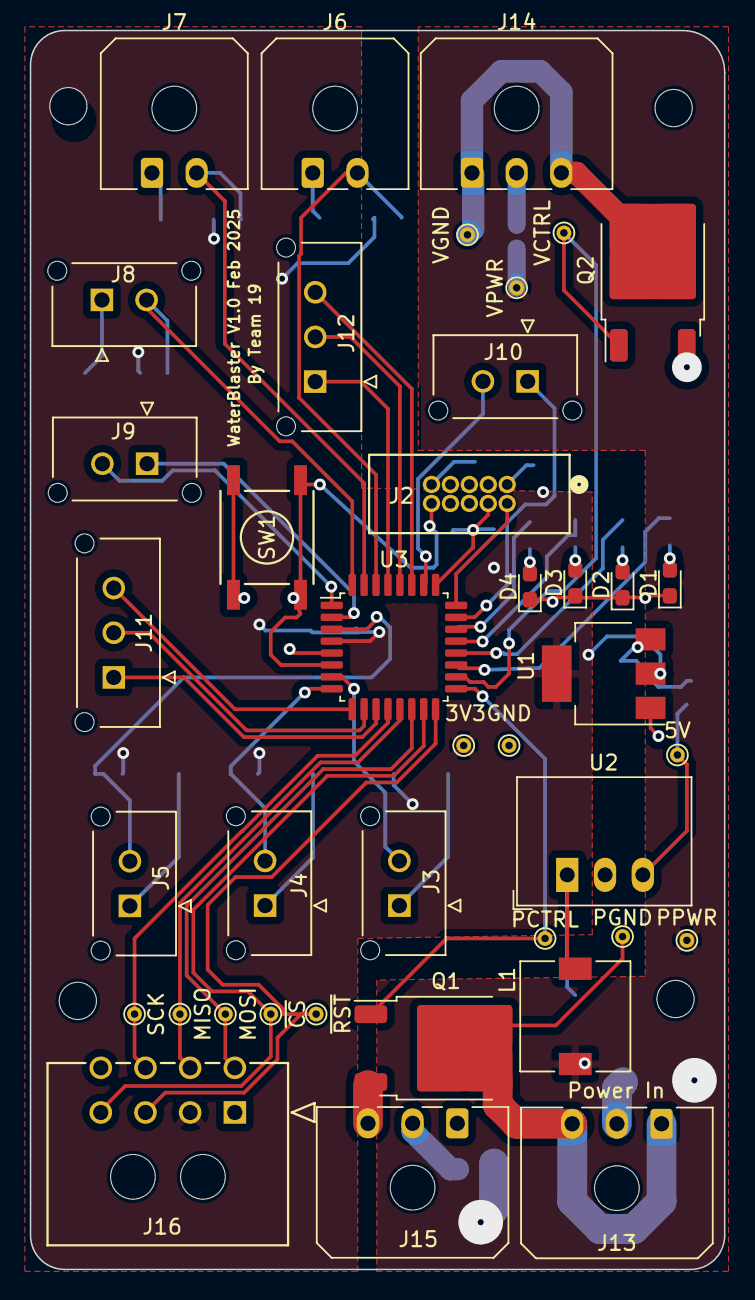
[picture p43: board WaterBlaster.kicad_pcb from above]

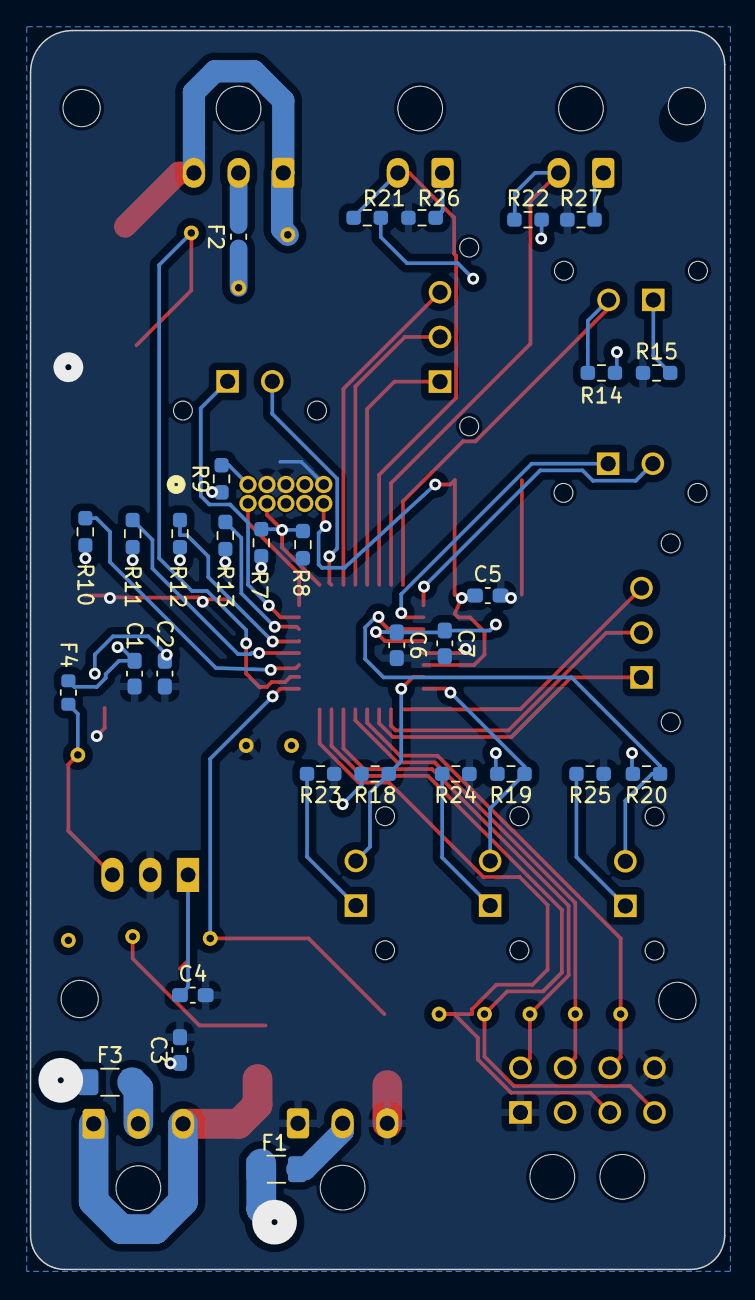
[picture p44: board WaterBlaster.kicad_pcb from below]

Board: 2 copper layers, 46.6 x 83.2 mm, 72 parts (33 on the bottom side), 51 nets.

Parts:
3V3: 3V3; TestPoint_THTPad_D1.0mm_Drill0.5mm
5V: 5v Protected; TestPoint_THTPad_D1.0mm_Drill0.5mm
C1, C2: 1.0uF; C_0603_1608Metric_Pad1.08x0.95mm_HandSolder
C3: 10uF; C_0603_1608Metric_Pad1.08x0.95mm_HandSolder
C4, C7: 4.7uF; C_0603_1608Metric_Pad1.08x0.95mm_HandSolder
C5: .1UF; C_0603_1608Metric_Pad1.08x0.95mm_HandSolder
C6: 100nF; C_0603_1608Metric_Pad1.08x0.95mm_HandSolder
D1: BLUE LED; LED_0603_1608Metric_Pad1.05x0.95mm_HandSolder
D2: RED LED; LED_0603_1608Metric_Pad1.05x0.95mm_HandSolder
D3: YELLOW LED; LED_0603_1608Metric_Pad1.05x0.95mm_HandSolder
D4: GREEN LED; LED_0603_1608Metric_Pad1.05x0.95mm_HandSolder
F1: 10A; Fuse_1206_3216Metric
F2: 1.2A; Fuse_0603_1608Metric
F3: 6A; Fuse_1206_3216Metric_Pad1.42x1.75mm_HandSolder
F4: Fuse; Fuse_0603_1608Metric
GND: GND; TestPoint_THTPad_D1.0mm_Drill0.5mm
H1, H2, H3, H4: MountingHole; MountingHole_2.5mm
J2: JTAG_Header; CONN_3220-10-0100-00_CNC
J3, J4, J5, J8, J10: Conn_01x02; MOLEX_436500227
J6, J7: Conn_01x02; Molex_Micro-Fit_3.0_43650-0200_1x02_P3.00mm_Horizontal
J9: WaterBlaster:MOLEX_436500227; MOLEX_436500227
J11, J12: Conn_01x03; MOLEX_436500317
J13, J14, J15: Conn_01x03; Molex_Micro-Fit_3.0_43650-0300_1x03_P3.00mm_Horizontal
J16: 430450800; CON_430450800_MOL
L1: 12uH; L_7.3x7.3_H3.5
MISO: MISO; TestPoint_THTPad_D1.0mm_Drill0.5mm
MOSI: MOSI; TestPoint_THTPad_D1.0mm_Drill0.5mm
PCTRL: PumpControl; TestPoint_THTPad_D1.0mm_Drill0.5mm
PGND: PumpGND; TestPoint_THTPad_D1.0mm_Drill0.5mm
PPWR: PumpPWR; TestPoint_THTPad_D1.0mm_Drill0.5mm
Q1, Q2: 353-MCU60N02-TPCT-ND; TO-252-2
R7, R8: R; R_0603_1608Metric_Pad0.98x0.95mm_HandSolder
R9: 0; R_0603_1608Metric_Pad0.98x0.95mm_HandSolder
R10, R11, R12, R13, R15, R23, R24, R25, R26, R27: 1k; R_0603_1608Metric_Pad0.98x0.95mm_HandSolder
R14, R18, R19, R20, R21, R22: 10k; R_0603_1608Metric_Pad0.98x0.95mm_HandSolder
SCK: SCK; TestPoint_THTPad_D1.0mm_Drill0.5mm
SW1: SW_Push; PTS645SL43SMTR92LFS_CNK
U1: AZ1117EH-3.3TRG1; SOT-223-3_TabPin2
U2: R-78E5.0-0.5; Converter_DCDC_RECOM_R-78E-0.5_THT
U3: STM32G070KBT6; LQFP-32_7x7mm_P0.8mm
VCTRL: ValveControl; TestPoint_THTPad_D1.0mm_Drill0.5mm
VGND: ValveGND; TestPoint_THTPad_D1.0mm_Drill0.5mm
VPWR: ValvePWR; TestPoint_THTPad_D1.0mm_Drill0.5mm

Connections:
+3V3: 3V3.1, C2.1, C6.1, C7.1, J16.2, R7.1, R9.1, R14.2, R18.2, R19.2, R20.2, R21.2, R22.2, U1.2 (VO), U3.4 (VDD/VDDA)
+5V: 5V.1, C1.1, F4.1, F4.2, U1.3 (VI), U2.3 (OUT)
+12V: C3.1, F1.2, F2.1, F3.1, L1.1, PPWR.1, VPWR.1
/Display/SCLK: J16.7, SCK.1, U3.12 (PA5)
/Display/SDI: J16.5, MOSI.1, U3.14 (PA7)
/Display/SDO: J16.6, MISO.1, U3.13 (PA6)
/Display//CS: J16.4, U3.15 (PB0)
/Display//RESET: J16.3, U3.16 (PB1)
/IO/Button1: J3.2, R18.1, U3.7 (PA0)
/IO/Button2: J4.2, R19.1, U3.8 (PA1)
/IO/Button3: J5.2, R20.1, U3.3 (PC15-OSC32_OUT)
/IO/Button4: J6.2, R21.1, U3.30 (PB6)
/IO/Button5: J7.2, R22.1, U3.31 (PB7)
/IO/Button6: J8.2, R14.1, U3.32 (PB8)
/IO/LED1: R10.1, U3.19 (PA9)
/IO/LED2: R11.1, U3.20 (PC6)
/IO/LED3: R12.1, U3.21 (PA10)
/IO/LED4: R13.1, U3.22 (PA11(PA9))
/MCU/ExtraConn_1_1: J10.1, U3.23 (PA12(PA10))
/MCU/ExtraConn_1_2: J10.2, U3.26 (PA15)
/MCU/ExtraConn_2_1: J9.2, U3.1 (PB9)
/MCU/ExtraConn_2_2: J9.1, U3.2 (PC14-OSC32_IN)
/MCU/ExtraConn_3_1: J11.3, U3.9 (PA2)
/MCU/ExtraConn_3_2: J11.2, U3.10 (PA3)
/MCU/ExtraConn_3_3: J11.1, U3.11 (PA4)
/MCU/ExtraConn_4_1: J12.3, U3.27 (PB3)
/MCU/ExtraConn_4_2: J12.2, U3.28 (PB4)
/MCU/ExtraConn_4_3: J12.1, U3.29 (PB5)
/MCU/PumpControl: PCTRL.1, Q1.1 (G), U3.17 (PB2)
/MCU/RESET: C5.1, J2.10 (~RESET), SW1.2, U3.6 (~RST)
/MCU/SWCLK: J2.4 (TCLK), R7.2, R8.2, U3.25 (PA14-BOOT0)
/MCU/SWDIO: J2.2 (TMS), U3.24 (PA13)
/MCU/ValveControl: Q2.1 (G), U3.18 (PA8), VCTRL.1
GND: C1.2, C2.2, C3.2, C4.2, C5.2, C6.2, C7.2, D1.1 (K), D2.1 (K), D3.1 (K), D4.1 (K), GND.1, J2.3 (GND), J2.5 (GND), J2.9 (GND), J15.1, J15.3, J16.1, J16.8, Q1.3 (S), Q2.3 (S), R8.1, R15.1, R23.1, R24.1, R25.1, R26.1, R27.1, SW1.1, U1.1 (GND), U2.2 (GND), U3.5 (VSS/VSSA)
unnamed: D1.2 (A), R10.2
unnamed: D2.2 (A), R11.2
unnamed: D3.2 (A), R12.2
unnamed: D4.2 (A), R13.2
unnamed: J2.1 (VCC), R9.2
unnamed: J3.1, R23.2
unnamed: J4.1, R24.2
unnamed: J5.1, R25.2
unnamed: J6.1, R26.2
unnamed: J7.1, R27.2
unnamed: J8.1, R15.2
unnamed: J13.1, J13.3, PGND.1, Q1.2 (D)
unnamed: F3.2, J13.2
unnamed: J14.1, J14.3, Q2.2 (D), VGND.1
unnamed: F2.2, J14.2
unnamed: F1.1, J15.2
unnamed: C4.1, L1.2, U2.1 (IN)
