clarkmt2/ECE_445_WaterBlaster/firmware/WaterBlasterV2Firmware/WaterBlasterV2Firmware.ioc

Mcu.UserName=STM32G070KBTx
PA0.Signal=ADC1_IN0
PA1.Signal=GPIO_Input
PA10.Signal=GPIO_Output
PA13.Signal=SYS_SWDIO
PA14-BOOT0.Signal=SYS_SWCLK
PA15.Signal=GPIO_Input
PA2.Signal=GPIO_Input
PA3.Signal=GPIO_Input
PA4.Signal=GPIO_Input
PA5.Signal=GPIO_Output
PA6.Signal=GPIO_Input
PA7.Signal=GPIO_Output
PA8.Signal=GPIO_Output
PA9.Signal=GPIO_Output
PB0.Signal=GPIO_Output
PB1.Signal=GPIO_Output
PB2.Signal=GPIO_Output
PB3.Signal=GPIO_Input
PB4.Signal=GPIO_Input
PB5.Signal=GPIO_Input
PB6.Signal=GPIO_Input
PB7.Signal=GPIO_Input
PB8.Signal=GPIO_Input
PB9.Signal=GPIO_Input
PC6.Signal=GPIO_Output
