clarkmt2/ECE_445_WaterBlaster/firmware/STMProject/Core/Inc/NHD_2066.h

#define RS   30
#define E    31
#define RES  32
#define CS   33

#define ASDA  20
#define ASCL  21

#define SCLK   52
#define SDIN   51
#define SDOUT  50

// R/W signal tied LOW (always write)
// SA0 signal tied LOW

void init_oled();
void send_packet(unsigned char x);
void data(unsigned char d);
void command(unsigned char c);
