clarkmt2/ECE_445_WaterBlaster/(commit log)

2025-03-04 Pushing complete PCB
    [Display.kicad_sch, IO.kicad_sch, MCU.kicad_sch, PowerProtection.kicad_sch, PumpAndValve.kicad_sch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]
2025-03-13 Updating firmware and CAD
    [BladderEnclosureV1.prt, Display.kicad_sch, IO.kicad_sch, MCU.kicad_sch, NHD-0420CW-AB3.prt, NHD-0420CW-AB3.step, PowerProtection.kicad_sch, PrusaBuildSizemk1.0.prt]
2025-03-23 Creating Leak Sensor, Code Push, V2 PCB adding support for LEDs, Pressure Transducer, and IO Board, switched high current to use screw terminals, added 3v3 DCDC instead of LDO
    [Display.kicad_sch, IO.kicad_sch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]
2025-03-25 created IO board, leak detection sensor, and trigger board
    [IOBoardV1-B_Cu.gbr, IOBoardV1-B_Mask.gbr, IOBoardV1-B_Paste.gbr, IOBoardV1-B_Silkscreen.gbr, IOBoardV1-Edge_Cuts.gbr, IOBoardV1-F_Cu.gbr, IOBoardV1-F_Mask.gbr, IOBoardV1-F_Paste.gbr]
2025-04-08 V2 Firmware
    [PowerProtection.kicad_sch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]
2025-04-20 Big CAD Commit
    [0,250' NPT TEE.STEP, 0,250' NPT TEE.prt, 0.25inNPTFemaleFemaleConnector.prt, 0.25inNPTFemaleFemaleConnectorv2.prt, 0.25inNPTMaleMaleConnector.prt, 0.25to0.125inNPTMaletoBarb.prt, 0.25to0.375inNPTMaletoBarb.prt, 0.25to0.5inNPTFemaletoMale.prt]
2025-04-22 Updated shit
    [IOBoardV1.kicad_pcb, LeakDetectionSensorV1.kicad_pcb, LeakDetectionSensorV1.step, TriggerButton V1.kicad_pcb, TriggerButton V1.step, WaterBlasterV2.kicad_pcb, WaterBlasterV2.step]
2025-04-27 added hella CAD
    [0.5inNPT90Degree.prt, PrusaBuildSizemk1.0.prt, battery_holder.prt, button_covers2.prt, dcdc.prt, waterblaster_body_full.prt, waterblaster_leftback.prt, waterblaster_leftfront.prt]
2025-04-29 Firmware updates
    [Display.kicad_sch, IO.kicad_sch, MCU.kicad_sch, PowerProtection.kicad_sch, PumpControl.kicad_sch, Untitled.kicad_pcb, Untitled.kicad_sch, leakSensor.kicad_sch]
2025-05-02 Updating firmware and PCB
2025-05-02 Updated naming
    [Display.kicad_sch, IO.kicad_sch, MCU.kicad_sch, PowerProtection.kicad_sch, PumpControl.kicad_sch, WaterBlasterLite.kicad_pcb, WaterBlasterLite.kicad_sch, leakSensor.kicad_sch]
