clarkmt2/ECE_445_WaterBlaster/(notices)

Notices in the files:
firmware/WaterBlasterV2Firmware/Core/Src/main.c:
Copyright (c) 2025 STMicroelectronics.
All rights reserved.
This software is licensed under terms that can be found in the LICENSE file
